EdisonAltamirano/LDO_board/Report/pcb_design_report.pdf

# EE 372B — Custom PCB Design Report

Edison Altamirano | Francisco Hernandez-Gardea | Sahan Samarakoon
| October 5, 2026

## 1 Schematic and Layout

### 1.1 Schematic

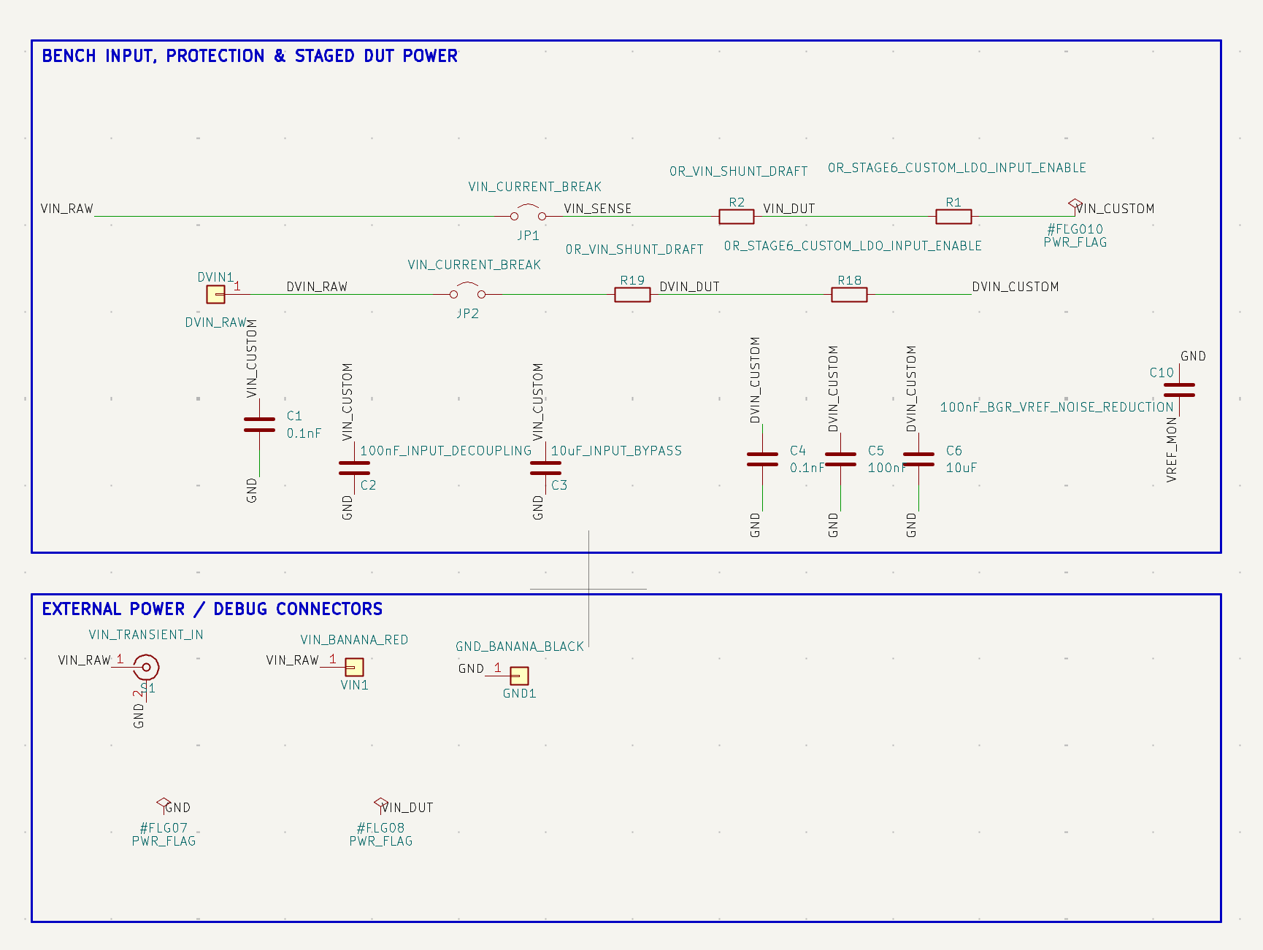
[picture p1: figure]

Figure 1: Schematic of Power Rails

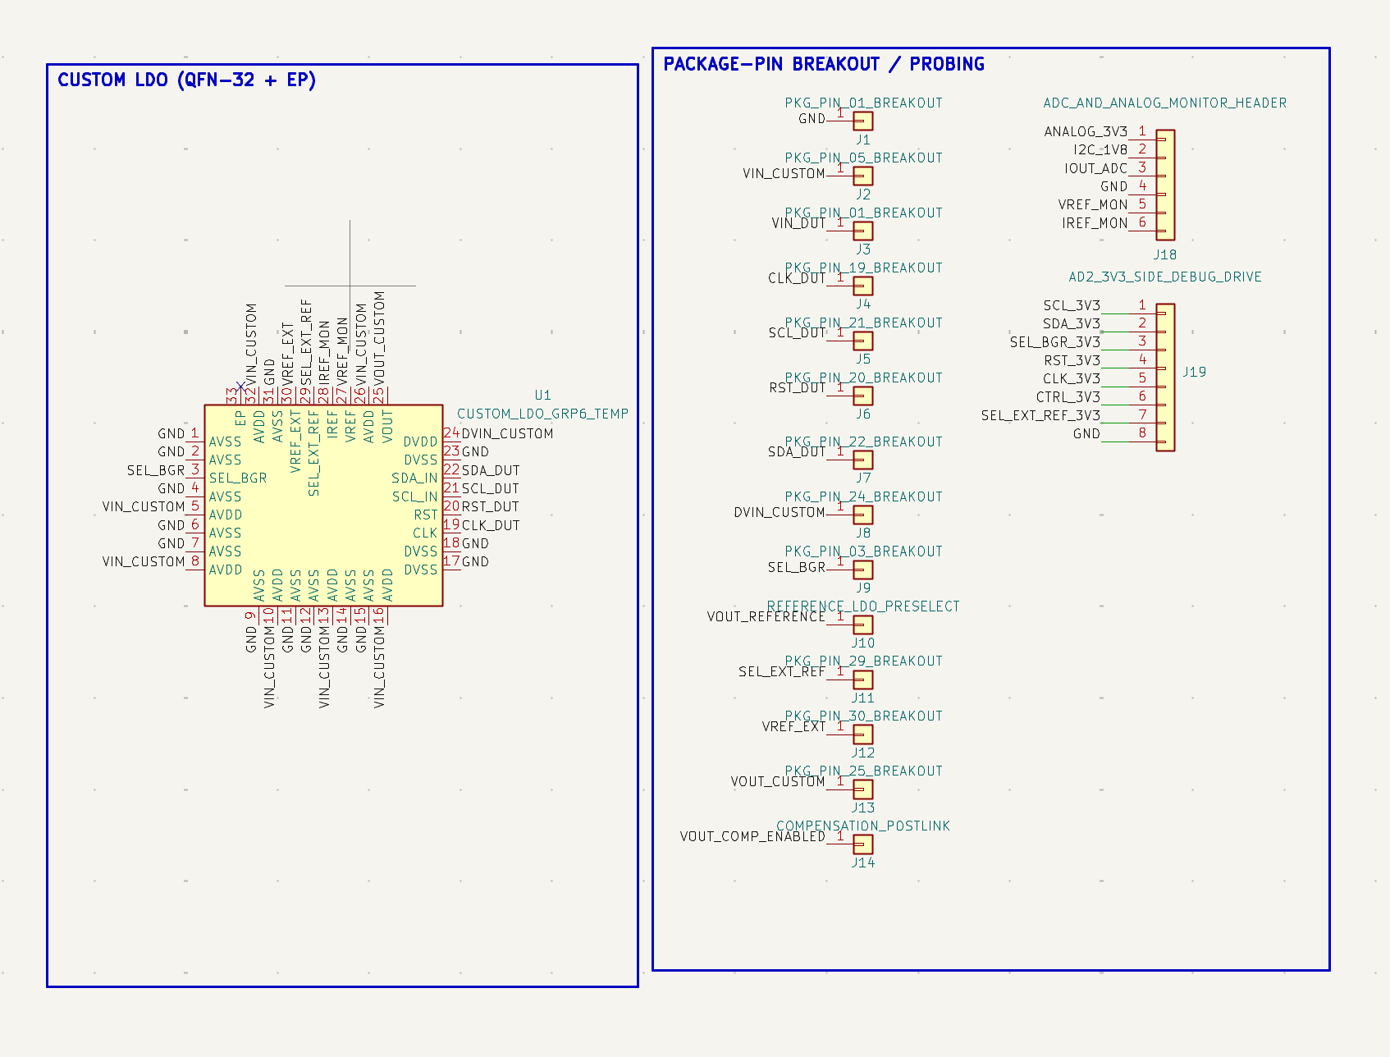
[picture p2: figure]

Figure 2: Schematic of IC and Test pins

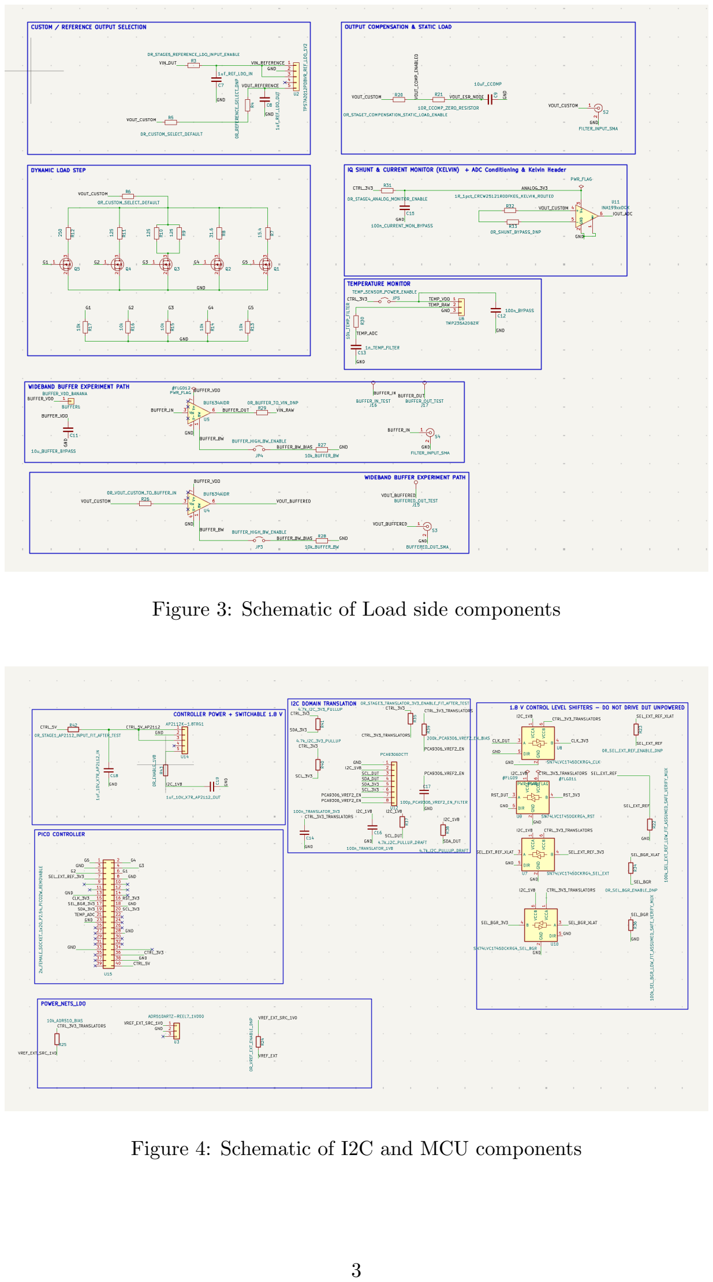
[picture p3: page 3]

Figure 3: Schematic of Load side components

Figure 4: Schematic of I2C and MCU components

### 1.2 Layout

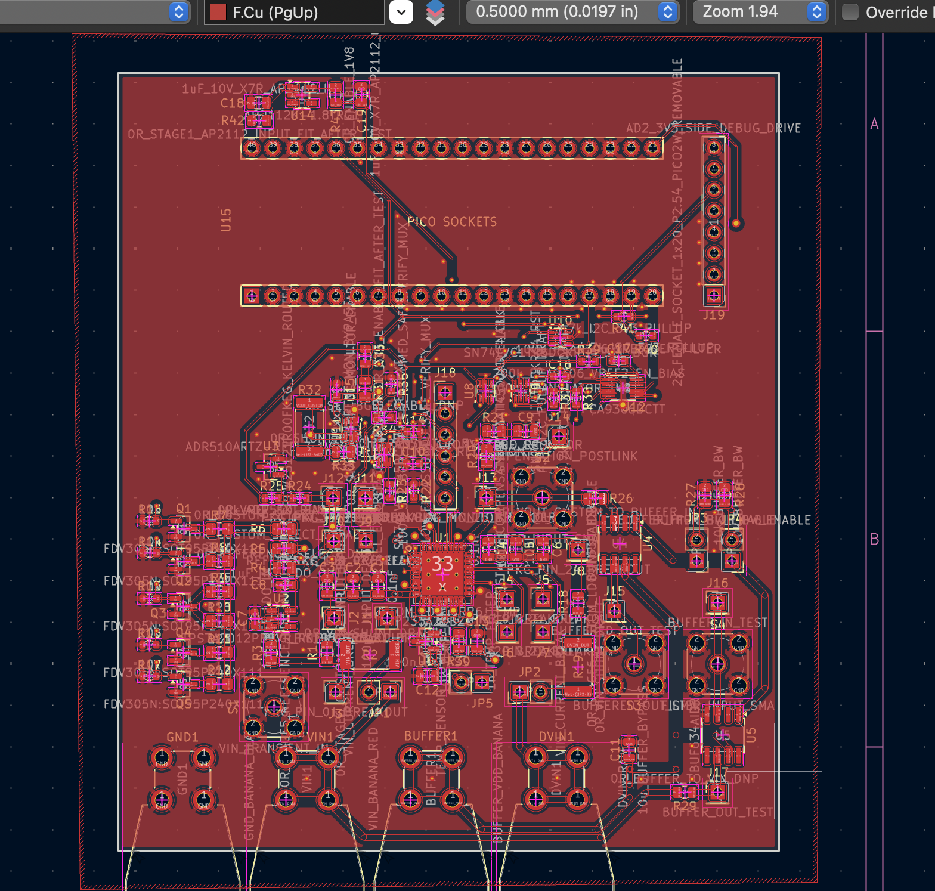
[picture p4: figure]

Figure 5: Top Layer Layout

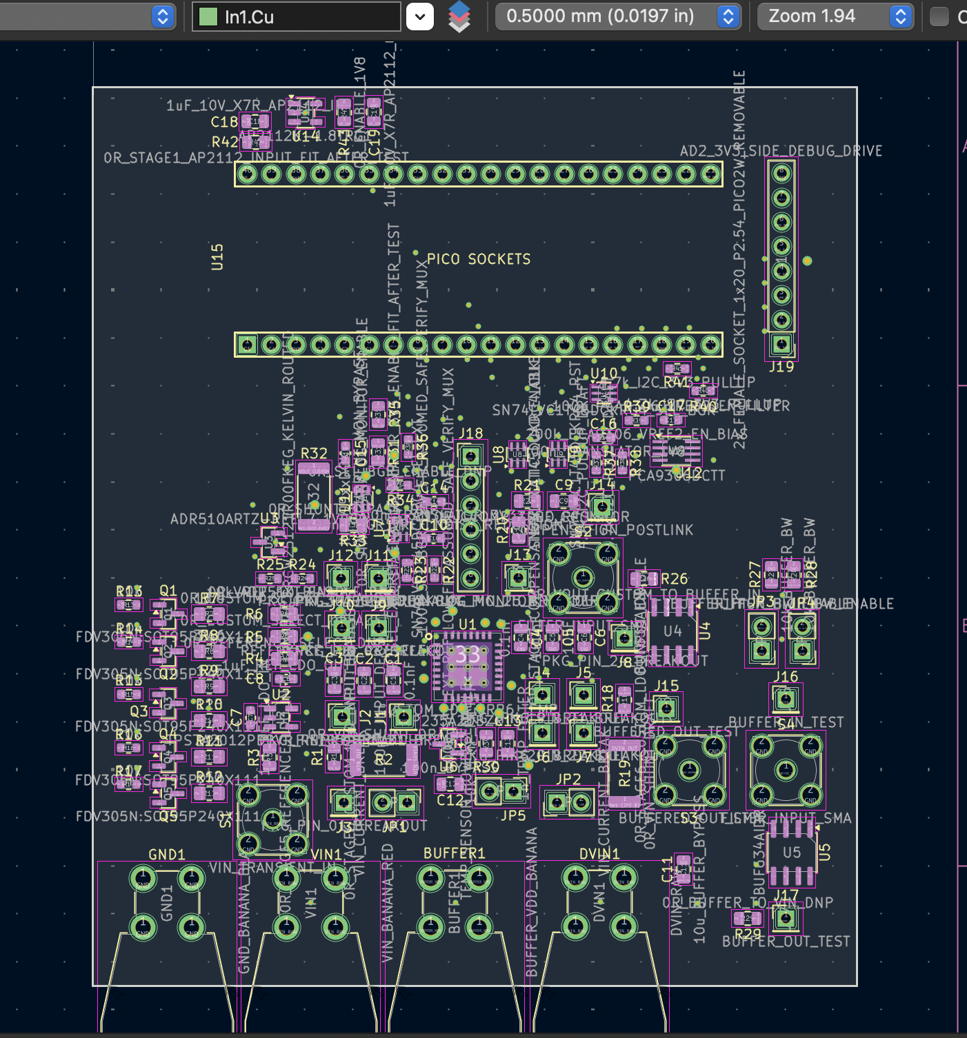
[picture p5: figure]

Figure 6: Second Layer Layout

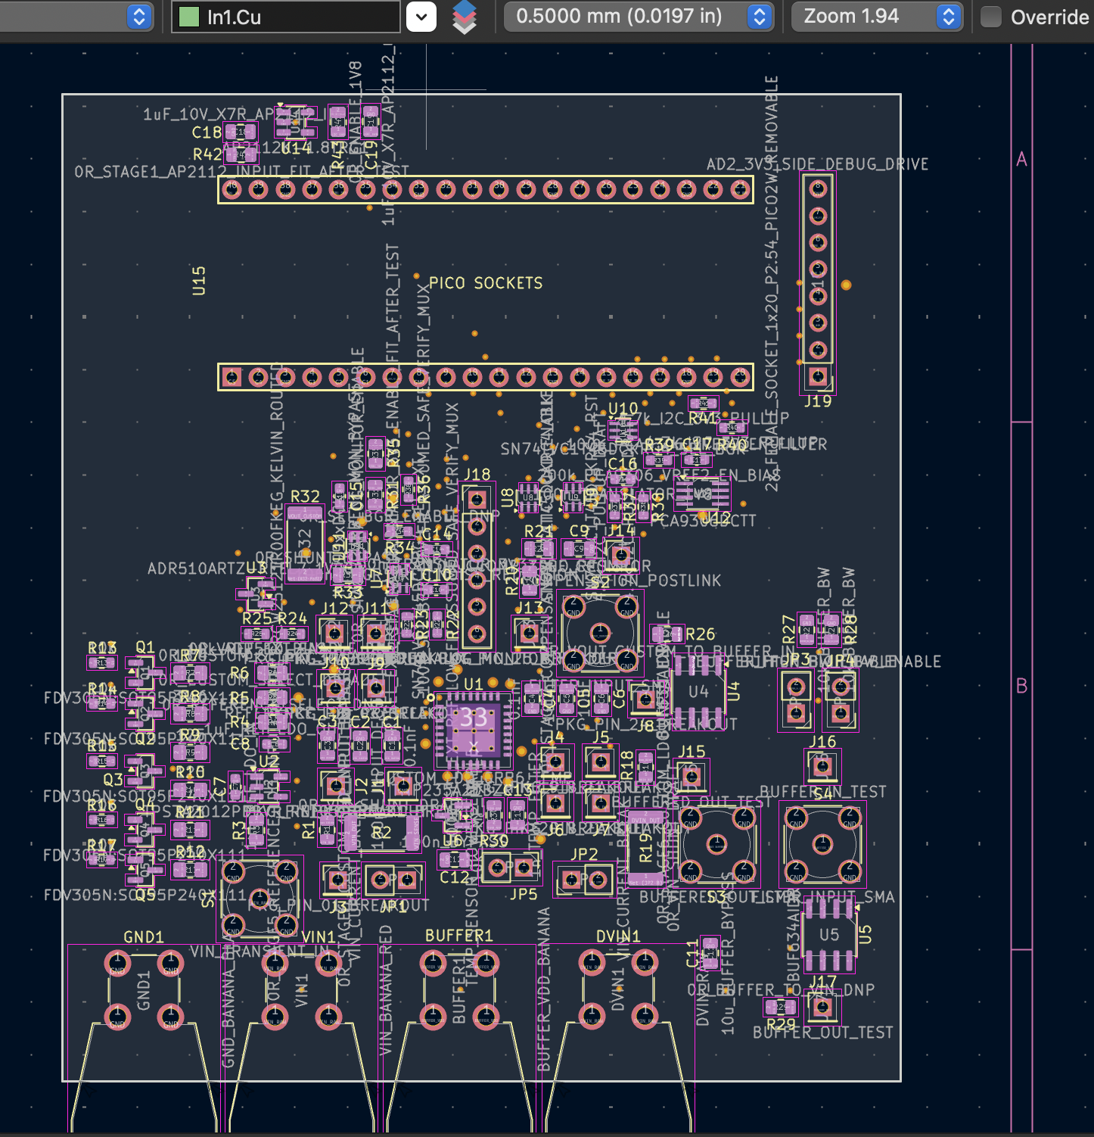
[picture p6: figure]

Figure 7: Third Layer Layout

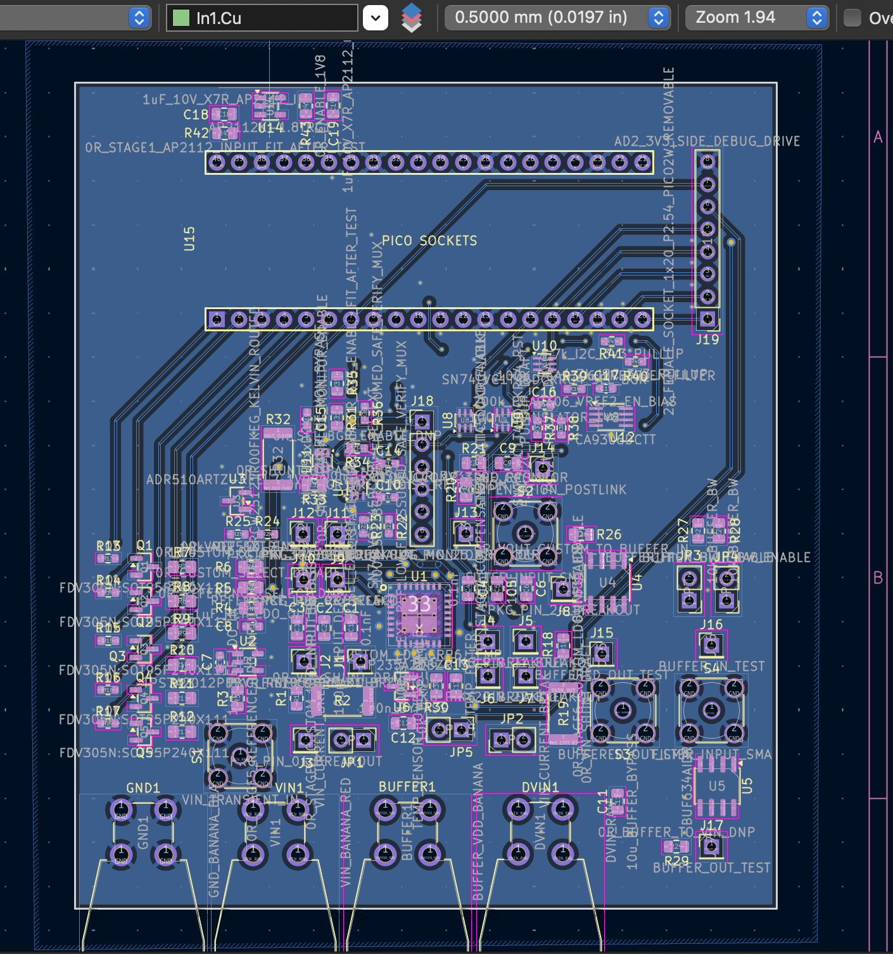
[picture p7: figure]

Figure 8: Bottom Layer Layout

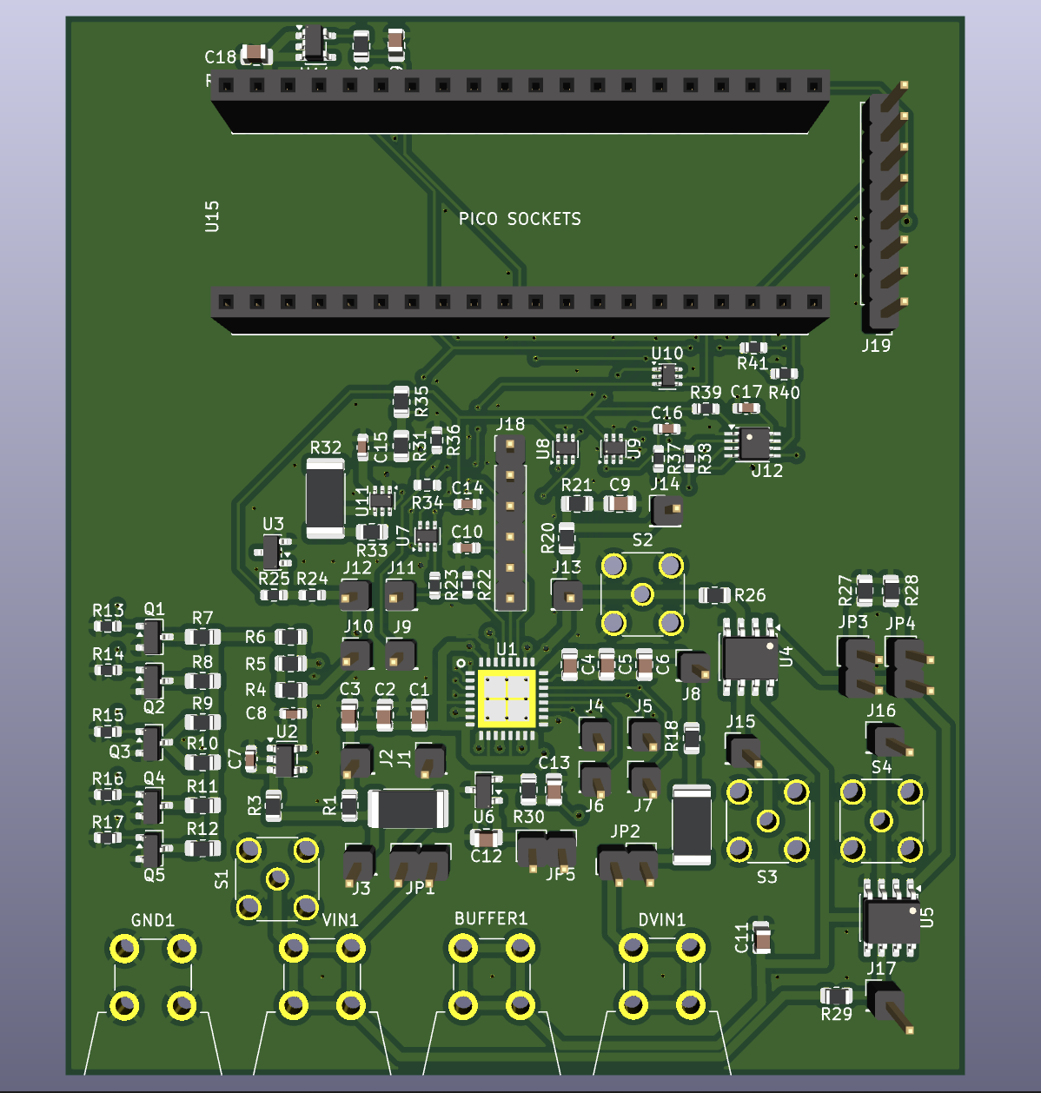
[picture p8: figure]

Figure 9: 3D View of PCB

## 2 Pin-Map and Footprint Verification

Table 1: QFN-32 + EP Footprint Dimensions

Feature | Value
Signal pad size | 0.35 mm × 0.8 mm
Pad pitch | 0.65 mm
Exposed-pad (EP) land | 5.1 mm ×5.1 mm
EP thermal vias | 9 vias, 0.3 mm drill
Courtyard | 7.55 mm × 7.55 mm

Table 2: Package Pin-Map Verification

Pkg Lead | Pad # | Pad Type | Cadence Net | KiCad Pin Name | Board Net | Checked
1 | 1 | PVSS2AC | VSS | AVSS | GND | SS
2 | 2 | PVSS2AC | VSS | AVSS | GND | SS
3 | 3 | PDB3AC | SEL BGR | SEL BGR | SEL BGR | SS
4 | 4 | PVSS2AC | VSS | AVSS | GND | SS
5 | 5 | PVDD3AC | VDD | AVDD | VIN CUSTOM | SS
6 | 6 | PVSS2AC | VSS | AVSS | GND | SS
7 | 7 | PVSS2AC | VSS | AVSS | GND | SS
8 | 8 | PVDD3AC | VDD | AVDD | VIN CUSTOM | SS
9 | 9 | PVSS2AC | VSS | AVSS | GND | SS
10 | 10 | PVDD3AC | VDD | AVDD | VIN CUSTOM | SS
11 | 11 | PVSS2AC | VSS | AVSS | GND | SS
12 | 12 | PVSS2AC | VSS | AVSS | GND | SS
13 | 13 | PVDD3AC | VDD | AVDD | VIN CUSTOM | SS
14 | 14 | PVSS2AC | VSS | AVSS | GND | SS
15 | 15 | PVSS2AC | VSS | AVSS | GND | SS
16 | 16 | PVDD3AC | VDD | AVDD | VIN CUSTOM | SS
17 | 17 | PVSS2AC | VSS | DVSS | GND | SS
18 | 18 | PVSS2AC | VSS | DVSS | GND | SS
19 | 19 | PDB3AC | CLK | CLK | CLK DUT | SS
20 | 20 | PDB3AC | RST | RST | RST DUT | SS
21 | 21 | PDB3AC | SCL IN | SCL IN | SCL DUT | SS
22 | 22 | PDB3AC | SDA IN | SDA IN | SDA DUT | SS
23 | 23 | PVSS2AC | VSS | DVSS | GND | SS
24 | 24 | PVDD3AC | VDD | DVDD | DVIN CUSTOM | SS
25 | 25 | PDB3AC | VOUT | VOUT | VOUT CUSTOM | SS
26 | 26 | PVDD3AC | VDD | AVDD | VIN CUSTOM | SS
27 | 27 | PDB3AC | VREF | VREF | VREF MON | SS
28 | 28 | PDB3AC | IREF | IREF | IREF MON | SS
29 | 29 | PDB3AC | SEL EXT REF | SEL EXT REF | SEL EXT REF | SS
30 | 30 | PDB3AC | V REF EXT | V REF EXT | V REF EXT | SS
31 | 31 | PVSS2AC | VSS | AVSS | GND | SS
32 | 32 | PVDD3AC | VDD | AVDD | VIN CUSTOM | SS
EP | 33 | EP | N/A | EP | N/A | SS

## 3 Test Features

### 3.1 Rail Inventory

Table 3 summarizes the supply and ground domains brought out from the custom IC. The analog and digital supply domains are kept separate on the PCB to allow independent characterization.

Table 3: Custom IC Rail Inventory
Board Rail | IC Domain / Pins | Nominal | Access / Isolation | Local Decoupling
VIN CUSTOM | Analog supply (AVDD), pins 5, 8, 10, 13, 16, 26,
| 32 | 1.8 V | Independent analog sup- ply path with current- break jumper and 0 Ω
series link. | Rail may
| | | be swept below 1.8 V for line-regulation and dropout measurements. | 100 pF, 100 nF, and 10 µF
DVIN CUSTOM | Digital supply (DVDD),
pin 24

1.8 V Independent digital supply path with current-break jumper and 0 Ω series link; may remain at
1.8 V while VIN CUSTOM
is swept.

100 pF, 100 nF, and 10
µF
GND | Analog | and | digital
grounds (AVSS: 1, 2, 4,
6, 7, 9, 11, 12, 14, 15,
31; DVSS: 17, 18, 23)

0 V Common solid ground
plane and ground test
points

—

The exposed pad, pin 33, is maintained as the separate EP NET connection and is not treated as an independent supply rail.

### 3.2 Specification Measurement Access

Table 4 summarizes the PCB features used to characterize the custom LDO and on-chip reference circuits.

Table 4: Specification-to-Board Measurement Feature Mapping
Specification | Relevant Net(s) | Board Measurement Feature
DC output voltage | VOUT CUSTOM | Direct custom-LDO output test point
| | (TP37); additional monitored output
| | available through the VOUT measure-
| | ment path.
Line regulation / dropout | VIN CUSTOM, VOUT CUSTOM | Sweep the analog bench supply while
| | monitoring VIN CUSTOM at TP28 and
| | the custom LDO output. DVIN CUSTOM
| | can remain independently powered at
| | 1.8 V.
Load regulation | VOUT, VOUT EXTERNAL | J110 external-load terminal block; 1
| | Ω Kelvin current shunt and INA180
| | current monitor provide load-current
| | measurement.
Load transient response | DYN GATE DRIVE, VOUT | J102 LOAD STEP DRIVE SMA drives
| | the MOSFET load-step circuit; mon-
| | itor VOUT using TP45 or J114.
PSRR | VIN RAW/VIN CUSTOM, VOUT | J59 VIN TRANSIENT IN SMA provides
| | AC input injection; output ripple is
| | observed at J114 VOUT SCOPE NOISE.
Output noise | VOUT | J114 VOUT SCOPE NOISE SMA provides
| | a coaxial connection for low-noise out-
| | put measurement.
Quiescent current (IQ) | VIN CUSTOM | Remove the analog VIN current-break
| | jumper and insert a DMM or SMU in
| | series with the DUT analog supply.
Reference voltage | VREF MON | VREF probe access through J68
| | and the analog monitor header J111;
| | package-pin breakout also provides di-
| | rect access.
Reference current | IREF MON | IREF probe access through J68 and
| | the analog monitor header J111;
| | package-pin breakout also provides di-
| | rect access.
Temperature dependence | VOUT, VREF MON, TEMP ADC | On-board temperature monitor can be
| | read by the Pico and correlated with
| | VOUT and VREF measurements.
Digital control / trim | SDA DUT, SCL DUT, CLK DUT, RST DUT | Pico controller and 1.8 V level-
| | translation circuitry exercise the dig-
| | ital interface; all DUT pins are addi-
| | tionally broken out for probing.

## 4 DRC and ERC Reports

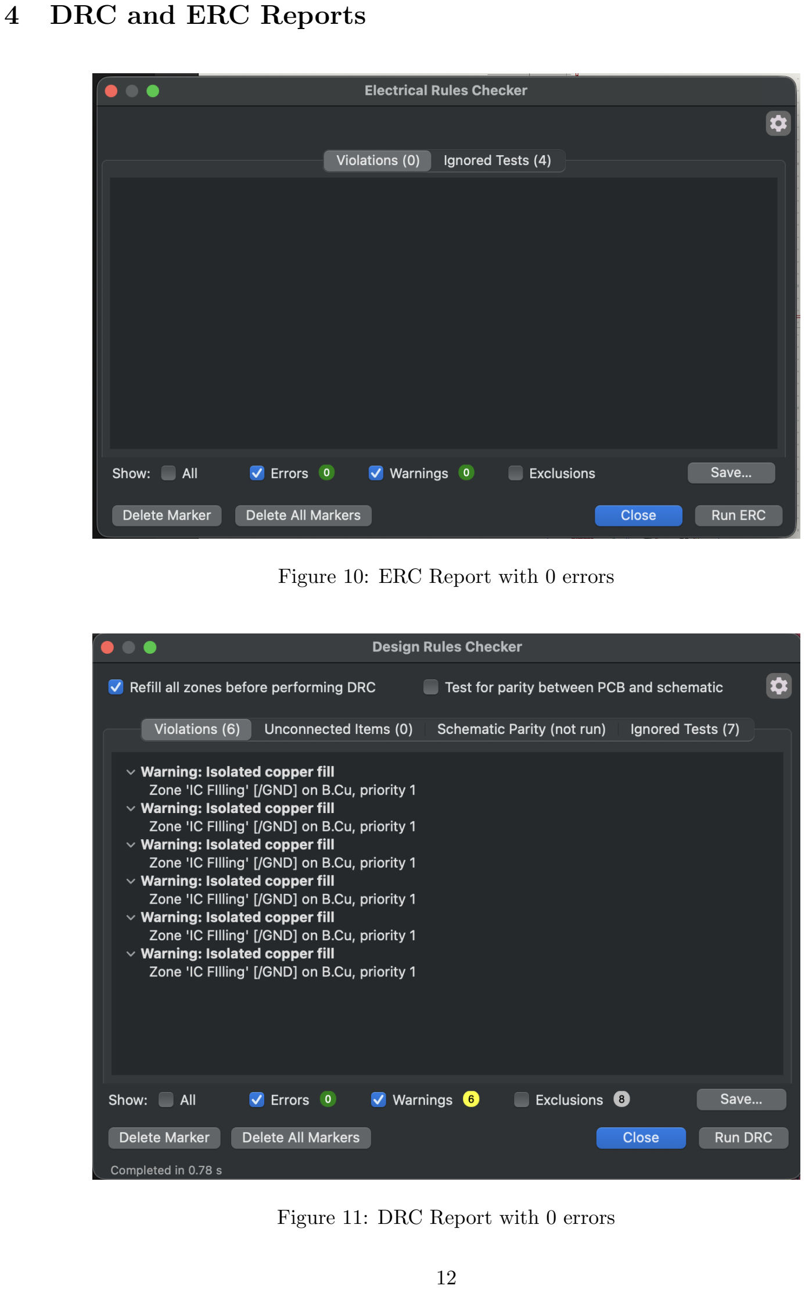
[picture p9: page 12]

Figure 10: ERC Report with 0 errors

Figure 11: DRC Report with 0 errors
