EdisonAltamirano/LDO_board/GerberFiles/board_bottom.png

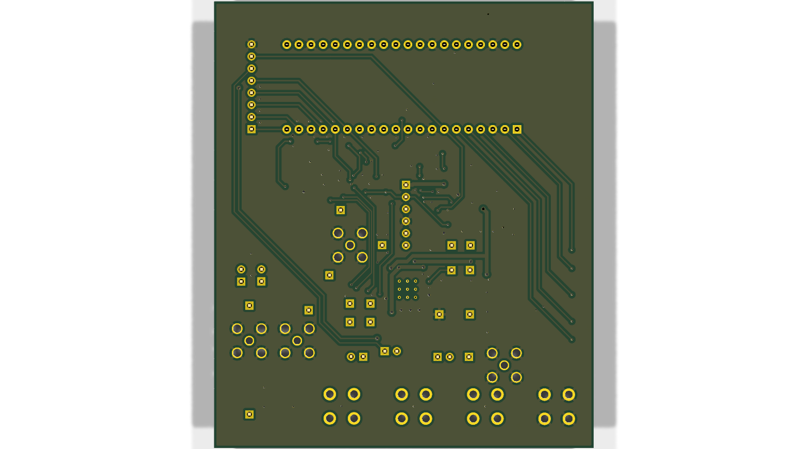
GerberFiles/board_bottom.png
