EdisonAltamirano/LDO_board/GerberFiles/board_top.png

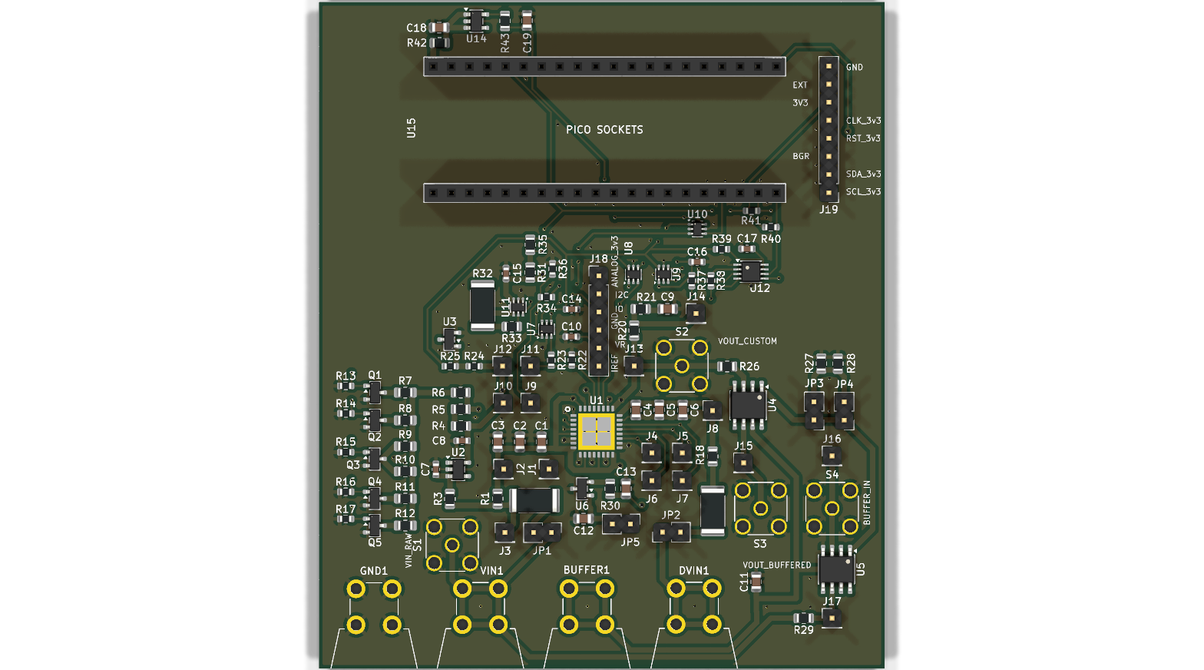
GerberFiles/board_top.png
