EdisonAltamirano/LDO_board/BOM/BOM_ldo.csv

Index | Quantity | Part Number | Manufacturer Part Number | Description | Unit of Measure | Customer Reference | Available | Backorder | Unit Price | Extended Price USD
1 | 2 | 399-15004-1-ND | C0805C101K8RACTU | CAP CER 100PF 10V X7R 0805 |  |  | 2 | 0 | 0.36000 | $0.72
2 | 3 | 399-C0805C104K8RACTUCT-ND | C0805C104K8RACTU | CAP CER 0.1UF 10V X7R 0805 |  |  | 3 | 0 | 0.22000 | $0.66
3 | 3 | 399-15687-1-ND | C0805C106K8RACAUTO | CAP CER 10UF 10V X7R 0805 |  |  | 3 | 0 | 0.70000 | $2.10
4 | 2 | 399-C0805C105K8RACTUCT-ND | C0805C105K8RACTU | CAP CER 1UF 10V X7R 0805 |  |  | 2 | 0 | 0.33000 | $0.66
5 | 4 | 399-C0603C104K5RACTUCT-ND | C0603C104K5RACTU | CAP CER 0.1UF 50V X7R 0603 |  |  | 4 | 0 | 0.14000 | $0.56
6 | 1 | 399-C0603C101J5GACTUCT-ND | C0603C101J5GACTU | CAP CER 100PF 50V C0G/NP0 0603 |  |  | 1 | 0 | 0.14000 | $0.14
7 | 2 | 399-C0603C105K4RACTUCT-ND | C0603C105K4RACTU | CAP CER 1UF 16V X7R 0603 |  |  | 2 | 0 | 0.15000 | $0.30
8 | 1 | 399-C0805C102K5GECAUTOCT-ND | C0805C102K5GECAUTO | CAP CER 0805 1NF 50V C0G 10% |  |  | 1 | 0 | 0.26000 | $0.26
9 | 1 | 445-8806-1-ND | CGA5L1X7R1E106K160AE | CAP CER 10UF 25V X7R 1206 |  |  | 1 | 0 | 1.20000 | $1.20
10 | 2 | 277-1258-ND | 1715022 | TERM BLK 2POS SIDE ENTRY 5MM PCB |  |  | 2 | 0 | 1.16000 | $2.32
11 | 4 | ACX1230-ND | 132134 | CONN SMA JACK STR 50 OHM PCB |  |  | 4 | 0 | 7.30000 | $29.20
12 | 2 | BKCT3151SP-2-ND | CT3151SP-2 | CONN BANANA JACK SOLDER RED |  |  | 2 | 0 | 2.55000 | $5.10
13 | 1 | BKCT3151SP-6-ND | CT3151SP-6 | CONN BANANA JACK SOLDER BLUE |  |  | 1 | 0 | 2.55000 | $2.55
14 | 1 | BKCT3151SP-0-ND | CT3151SP-0 | CONN BANANA JACK SOLDER BLACK |  |  | 1 | 0 | 2.55000 | $2.55
15 | 5 | 35-PBC02SAAN-ND | PBC02SAAN | CONN HEADER VERT 2POS 2.54MM |  |  | 5 | 0 | 0.25000 | $1.25
16 | 2 | S7018-ND | PPTC201LFBN-RC | CONN HDR 20POS 0.1 TIN PCB |  |  | 2 | 0 | 1.15000 | $2.30
17 | 1 | 35-PBC08SAAN-ND | PBC08SAAN | CONN HEADER VERT 8POS 2.54MM |  |  | 1 | 0 | 0.75000 | $0.75
18 | 12 | 35-PBC01SAAN-ND | PBC01SAAN | CONN HEADER VERT 1POS |  |  | 12 | 0 | 0.11100 | $1.33
19 | 1 | 35-PBC06SAAN-ND | PBC06SAAN | CONN HEADER VERT 6POS 2.54MM |  |  | 1 | 0 | 0.60000 | $0.60
20 | 5 | FDV305NCT-ND | FDV305N | MOSFET N-CH 20V 900MA SOT23 |  |  | 5 | 0 | 0.52000 | $2.60
21 | 2 | YAG1232CT-ND | RC2512JK-070RL | RES 0 OHM JUMPER 1W 2512 |  |  | 2 | 0 | 0.21000 | $0.42
22 | 30 | RMCF0805ZT0R00CT-ND | RMCF0805ZT0R00 | RES 0 OHM JUMPER 1/8W 0805 |  |  | 30 | 0 | 0.00880 | $0.26
23 | 1 | RMCF0603FT200KCT-ND | RMCF0603FT200K | RES 200K OHM 1% 1/10W 0603 |  |  | 1 | 0 | 0.10000 | $0.10
24 | 2 | 311-100KHRCT-ND | RC0603FR-07100KL | RES 100K OHM 1% 1/10W 0603 |  |  | 2 | 0 | 0.10000 | $0.20
25 | 2 | 541-1.00AAFCT-ND | CRCW25121R00FKEG | RES SMD 1 OHM 1% 1W 2512 |  |  | 2 | 0 | 0.34000 | $0.68
26 | 1 | 311-10.0CRCT-ND | RC0805FR-0710RL | RES 10 OHM 1% 1/8W 0805 |  |  | 1 | 0 | 0.12000 | $0.12
27 | 1 | A140011CT-ND | RQ73C2A249RBTD | RES 249 OHMS 0.1% 1/5W 0805 |  |  | 1 | 0 | 0.60000 | $0.60
28 | 3 | A139850CT-ND | RQ73C2A124RBTD | RES 124 OHMS 0.1% 1/5W 0805 |  |  | 3 | 0 | 0.64000 | $1.92
29 | 1 | A140166CT-ND | RQ73C2A31R6BTD | RES 31.6 OHMS 0.1% 1/5W 0805 |  |  | 1 | 0 | 0.57000 | $0.57
30 | 1 | A139511CT-ND | RQ73C2A15R4BTD | RES 15.4 OHMS 0.1% 1/5W 0805 |  |  | 1 | 0 | 0.57000 | $0.57
31 | 4 | 36-5010-ND | 5010 | PC TEST POINT MULTIPURPOSE RED |  |  | 4 | 0 | 0.42000 | $1.68
32 | 1 | 296-27331-1-ND | INA199A2DCKR | IC OP AMP SC-70-6 |  |  | 1 | 0 | 0.64000 | $0.64
33 | 1 | 505-ADR510ARTZ-REEL7CT-ND | ADR510ARTZ-REEL7 | IC VREF SHUNT 0.35% SOT23-3 |  |  | 1 | 0 | 2.73000 | $2.73
34 | 1 | AP2112K-1.8TRG1DICT-ND | AP2112K-1.8TRG1 | IC REG LINEAR 1.8V 600MA SOT-25 |  |  | 1 | 0 | 0.26000 | $0.26
35 | 1 | 296-32200-1-ND | PCA9306DCTT | IC XLTR VL BIDIR SM8 |  |  | 1 | 0 | 1.41000 | $1.41
36 | 4 | 296-35969-1-ND | SN74LVC1T45DCKRG4 | IC XLTR VL BIDIR SC-70-6 |  |  | 4 | 0 | 0.92000 | $3.68
37 | 1 | 296-TMP235A2DBZRCT-ND | TMP235A2DBZR | LOW-POWER HIGH-ACCURACY ANALOG O |  |  | 1 | 0 | 0.56000 | $0.56
38 | 2 | 296-53619-1-ND | BUF634AIDR | IC OP AMP 1CH 8-SOIC |  |  | 2 | 0 | 4.63000 | $9.26
39 | 1 | 296-TPS7A2012PDBVRCT-ND | TPS7A2012PDBVR | IC REG LINEAR 1.2V 300MA SOT23-5 |  |  | 1 | 0 | 0.37000 | $0.37
40 | 6 | 311-10.0KHRCT-ND | RC0603FR-0710KL | RES 10K OHM 1% 1/10W 0603 |  |  | 6 | 0 | 0.10000 | $0.60
41 | 3 | RMCF0805FT10K0CT-ND | RMCF0805FT10K0 | RES 10K OHM 1% 1/8W 0805 |  |  | 3 | 0 | 0.10000 | $0.30
42 | 5 | S9001-ND | SPC02SYAN | CONN JUMPER SHORTING GOLD FLASH |  |  | 5 | 0 | 0.10000 | $0.50
43 | 4 | 311-4.70KHRCT-ND | RC0603FR-074K7L | RES 4.7K OHM 1% 1/10W 0603 |  |  | 4 | 0 | 0.10000 | $0.40
44 | 4 | 13-PA2512FKE7W0R1ECT-ND | PA2512FKE7W0R1E | RES 0.1 OHM 1% 2W 2512 |  |  | 4 | 0 | 0.52000 | $2.08
