EdisonAltamirano/LDO_board/GerberFiles/bom/BOM_schematic.csv

References | Value | Footprint | Quantity | DNP
BUFFER1 | BUFFER_VDD_BANANA | Connector:CalTest_CT3151 | 1
C1,C4 | 0.1nF | Capacitor_SMD:C_0805_2012Metric | 2
C2 | 100nF_INPUT_DECOUPLING | Capacitor_SMD:C_0805_2012Metric | 1
C3 | 10uF_INPUT_BYPASS | Capacitor_SMD:C_0805_2012Metric | 1
C5 | 100nF | Capacitor_SMD:C_0805_2012Metric | 1
C6 | 10uF | Capacitor_SMD:C_0805_2012Metric | 1
C7 | 1uF_REF_LDO_IN | Capacitor_SMD:C_0603_1608Metric | 1
C8 | 1uF_REF_LDO_OUT | Capacitor_SMD:C_0603_1608Metric | 1
C9 | 10uF_CCOMP | Capacitor_SMD:C_0805_2012Metric | 1
C10 | 100nF_BGR_VREF_NOISE_REDUCTION | Capacitor_SMD:C_0603_1608Metric | 1
C11 | 10u_BUFFER_BYPASS | Capacitor_SMD:C_0805_2012Metric | 1
C12 | 100n_BYPASS | Capacitor_SMD:C_0805_2012Metric | 1
C13 | 1n_TEMP_FILTER | Capacitor_SMD:C_0805_2012Metric | 1
C14 | 100n_TRANSLATOR_3V3 | Capacitor_SMD:C_0603_1608Metric | 1
C15 | 100n_CURRENT_MON_BYPASS | Capacitor_SMD:C_0603_1608Metric | 1
C16 | 100n_TRANSLATOR_1V8 | Capacitor_SMD:C_0603_1608Metric | 1
C17 | 100p_PCA9306_VREF2_EN_FILTER | Capacitor_SMD:C_0603_1608Metric | 1
C18 | 1uF_10V_X7R_AP2112_IN | Capacitor_SMD:C_0805_2012Metric | 1
C19 | 1uF_10V_X7R_AP2112_OUT | Capacitor_SMD:C_0805_2012Metric | 1
DVIN1 | DVIN_RAW | Connector:CalTest_CT3151 | 1
GND1 | GND_BANANA_BLACK | Connector:CalTest_CT3151 | 1
J1,J3 | PKG_PIN_01_BREAKOUT | Connector_PinHeader_2.54mm:PinHeader_1x01_P2.54mm_Vertical | 2
J2 | PKG_PIN_05_BREAKOUT | Connector_PinHeader_2.54mm:PinHeader_1x01_P2.54mm_Vertical | 1
J4 | PKG_PIN_19_BREAKOUT | Connector_PinHeader_2.54mm:PinHeader_1x01_P2.54mm_Vertical | 1
J5 | PKG_PIN_21_BREAKOUT | Connector_PinHeader_2.54mm:PinHeader_1x01_P2.54mm_Vertical | 1
J6 | PKG_PIN_20_BREAKOUT | Connector_PinHeader_2.54mm:PinHeader_1x01_P2.54mm_Vertical | 1
J7 | PKG_PIN_22_BREAKOUT | Connector_PinHeader_2.54mm:PinHeader_1x01_P2.54mm_Vertical | 1
J8 | PKG_PIN_24_BREAKOUT | Connector_PinHeader_2.54mm:PinHeader_1x01_P2.54mm_Vertical | 1
J9 | PKG_PIN_03_BREAKOUT | Connector_PinHeader_2.54mm:PinHeader_1x01_P2.54mm_Vertical | 1
J10 | REFERENCE_LDO_PRESELECT | Connector_PinHeader_2.54mm:PinHeader_1x01_P2.54mm_Vertical | 1
J11 | PKG_PIN_29_BREAKOUT | Connector_PinHeader_2.54mm:PinHeader_1x01_P2.54mm_Vertical | 1
J12 | PKG_PIN_30_BREAKOUT | Connector_PinHeader_2.54mm:PinHeader_1x01_P2.54mm_Vertical | 1
J13 | PKG_PIN_25_BREAKOUT | Connector_PinHeader_2.54mm:PinHeader_1x01_P2.54mm_Vertical | 1
J14 | COMPENSATION_POSTLINK | Connector_PinHeader_2.54mm:PinHeader_1x01_P2.54mm_Vertical | 1
J15 | BUFFERED_OUT_TEST | Connector_PinHeader_2.54mm:PinHeader_1x01_P2.54mm_Vertical | 1
J16 | BUFFER_IN_TEST | Connector_PinHeader_2.54mm:PinHeader_1x01_P2.54mm_Vertical | 1
J17 | BUFFER_OUT_TEST | Connector_PinHeader_2.54mm:PinHeader_1x01_P2.54mm_Vertical | 1
J18 | ADC_AND_ANALOG_MONITOR_HEADER | Connector_PinHeader_2.54mm:PinHeader_1x06_P2.54mm_Vertical | 1
J19 | AD2_3V3_SIDE_DEBUG_DRIVE | Connector_PinHeader_2.54mm:PinHeader_1x08_P2.54mm_Vertical | 1
JP1,JP2 | VIN_CURRENT_BREAK | Connector_PinHeader_2.54mm:PinHeader_1x02_P2.54mm_Vertical | 2
JP3,JP4 | BUFFER_HIGH_BW_ENABLE | Connector_PinHeader_2.54mm:PinHeader_1x02_P2.54mm_Vertical | 2
JP5 | TEMP_SENSOR_POWER_ENABLE | Connector_PinHeader_2.54mm:PinHeader_1x02_P2.54mm_Vertical | 1
Q1-Q5 | FDV305N:SOT95P240X111 | Package_TO_SOT_SMD:SOT-23 | 5
R1,R18 | 0R_STAGE6_CUSTOM_LDO_INPUT_ENABLE | Resistor_SMD:R_0805_2012Metric | 2
R2,R19 | 0R_VIN_SHUNT_DRAFT | Resistor_SMD:R_2512_6332Metric | 2
R3 | 0R_STAGE5_REFERENCE_LDO_INPUT_ENABLE | Resistor_SMD:R_0805_2012Metric | 1
R4 | 0R_REFERENCE_SELECT_DNP | Resistor_SMD:R_0805_2012Metric | 1
R5,R6 | 0R_CUSTOM_SELECT_DEFAULT | Resistor_SMD:R_0805_2012Metric | 2
R7 | 15.4 | Resistor_SMD:R_0805_2012Metric_Pad1.20x1.40mm_HandSolder | 1
R8 | 31.6 | Resistor_SMD:R_0805_2012Metric_Pad1.20x1.40mm_HandSolder | 1
R9-R11 | 125 | Resistor_SMD:R_0805_2012Metric_Pad1.20x1.40mm_HandSolder | 3
R12 | 250 | Resistor_SMD:R_0805_2012Metric_Pad1.20x1.40mm_HandSolder | 1
R13-R17 | 10k | Resistor_SMD:R_0603_1608Metric | 5
R20 | 0R_STAGE7_COMPENSATION_STATIC_LOAD_ENABLE | Resistor_SMD:R_0805_2012Metric | 1
R21 | 10R_CCOMP_ZERO_RESISTOR | Resistor_SMD:R_0805_2012Metric | 1
R22 | 100k_SEL_EXT_REF_LOW_FIT_ASSUMED_SAFE_VERIFY_MUX | Resistor_SMD:R_0603_1608Metric | 1
R23 | 0R_SEL_EXT_REF_ENABLE_DNP | Resistor_SMD:R_0603_1608Metric | 1
R24 | 0R_VREF_EXT_ENABLE_DNP | Resistor_SMD:R_0603_1608Metric | 1
R25 | 10k_ADR510_BIAS | Resistor_SMD:R_0603_1608Metric | 1
R26 | 0R_VOUT_CUSTOM_TO_BUFFER_IN | Resistor_SMD:R_0805_2012Metric | 1
R27,R28 | 10k_BUFFER_BW | Resistor_SMD:R_0805_2012Metric | 2
R29 | 0R_BUFFER_TO_VIN_DNP | Resistor_SMD:R_0805_2012Metric | 1
R30 | 10k_TEMP_FILTER | Resistor_SMD:R_0805_2012Metric | 1
R31 | 0R_STAGE4_ANALOG_MONITOR_ENABLE | Resistor_SMD:R_0805_2012Metric | 1
R32 | 1R_1pct_CRCW25121R00FKEG_KELVIN_ROUTED | Resistor_SMD:R_2512_6332Metric | 1
R33 | 0R_SHUNT_BYPASS_DNP | Resistor_SMD:R_0805_2012Metric | 1
R34 | 0R_SEL_BGR_ENABLE_DNP | Resistor_SMD:R_0603_1608Metric | 1
R35 | 0R_STAGE3_TRANSLATOR_3V3_ENABLE_FIT_AFTER_TEST | Resistor_SMD:R_0805_2012Metric | 1
R36 | 100k_SEL_BGR_LOW_FIT_ASSUMED_SAFE_VERIFY_MUX | Resistor_SMD:R_0603_1608Metric | 1
R37,R38 | 4.7k_I2C_PULLUP_DRAFT | Resistor_SMD:R_0603_1608Metric | 2
R39 | 200k_PCA9306_VREF2_EN_BIAS | Resistor_SMD:R_0603_1608Metric | 1
R40,R41 | 4.7k_I2C_3V3_PULLUP | Resistor_SMD:R_0603_1608Metric | 2
R42 | 0R_STAGE1_AP2112_INPUT_FIT_AFTER_TEST | Resistor_SMD:R_0805_2012Metric | 1
R43 | 0R_ENABLE_1V8 | Resistor_SMD:R_0805_2012Metric | 1
S1 | VIN_TRANSIENT_IN | Connector_Coaxial:SMA_Amphenol_132134_Vertical | 1
S2,S4 | FILTER_INPUT_SMA | Connector_Coaxial:SMA_Amphenol_132134_Vertical | 2
S3 | BUFFERED_OUT_SMA | Connector_Coaxial:SMA_Amphenol_132134_Vertical | 1
U1 | CUSTOM_LDO_GRP6_TEMP | custom_footprints:QFN32_7x7_P0.65_TEMP | 1
U2 | TPS7A2012PDBVR_REF_LDO_1V2 | Package_TO_SOT_SMD:SOT-23-5 | 1
U3 | ADR510ARTZ-REEL7_1V000 | Package_TO_SOT_SMD:SOT-23 | 1
U4,U5 | BUF634AIDR | Package_SO:SOIC-8_3.9x4.9mm_P1.27mm | 2
U6 | TMP235A2DBZR | Package_TO_SOT_SMD:SOT-23 | 1
U7 | SN74LVC1T45DCKRG4_SEL_EXT | Package_TO_SOT_SMD:SOT-363_SC-70-6 | 1
U8 | SN74LVC1T45DCKRG4_CLK | Package_TO_SOT_SMD:SOT-363_SC-70-6 | 1
U9 | SN74LVC1T45DCKRG4_RST | Package_TO_SOT_SMD:SOT-363_SC-70-6 | 1
U10 | SN74LVC1T45DCKRG4_SEL_BGR | Package_TO_SOT_SMD:SOT-363_SC-70-6 | 1
U11 | INA199xxDCK | Package_TO_SOT_SMD:SOT-363_SC-70-6 | 1
U12 | PCA9306DCTT | Package_SO:SSOP-8_2.95x2.8mm_P0.65mm | 1
U14 | AP2112K-1.8TRG1 | Package_TO_SOT_SMD:SOT-23-5 | 1
U15 | 2x_FEMALE_SOCKET_1x20_P2.54_PICO2W_REMOVABLE | custom_footprints:Pico_2W_Dual_1x20_Female_Sockets | 1
VIN1 | VIN_BANANA_RED | Connector:CalTest_CT3151 | 1
