EdisonAltamirano/LDO_board/SchematicFiles/ldo_eval.kicad_pcb

## KiCad design SchematicFiles/ldo_eval.kicad_pcb (2026-10-05)

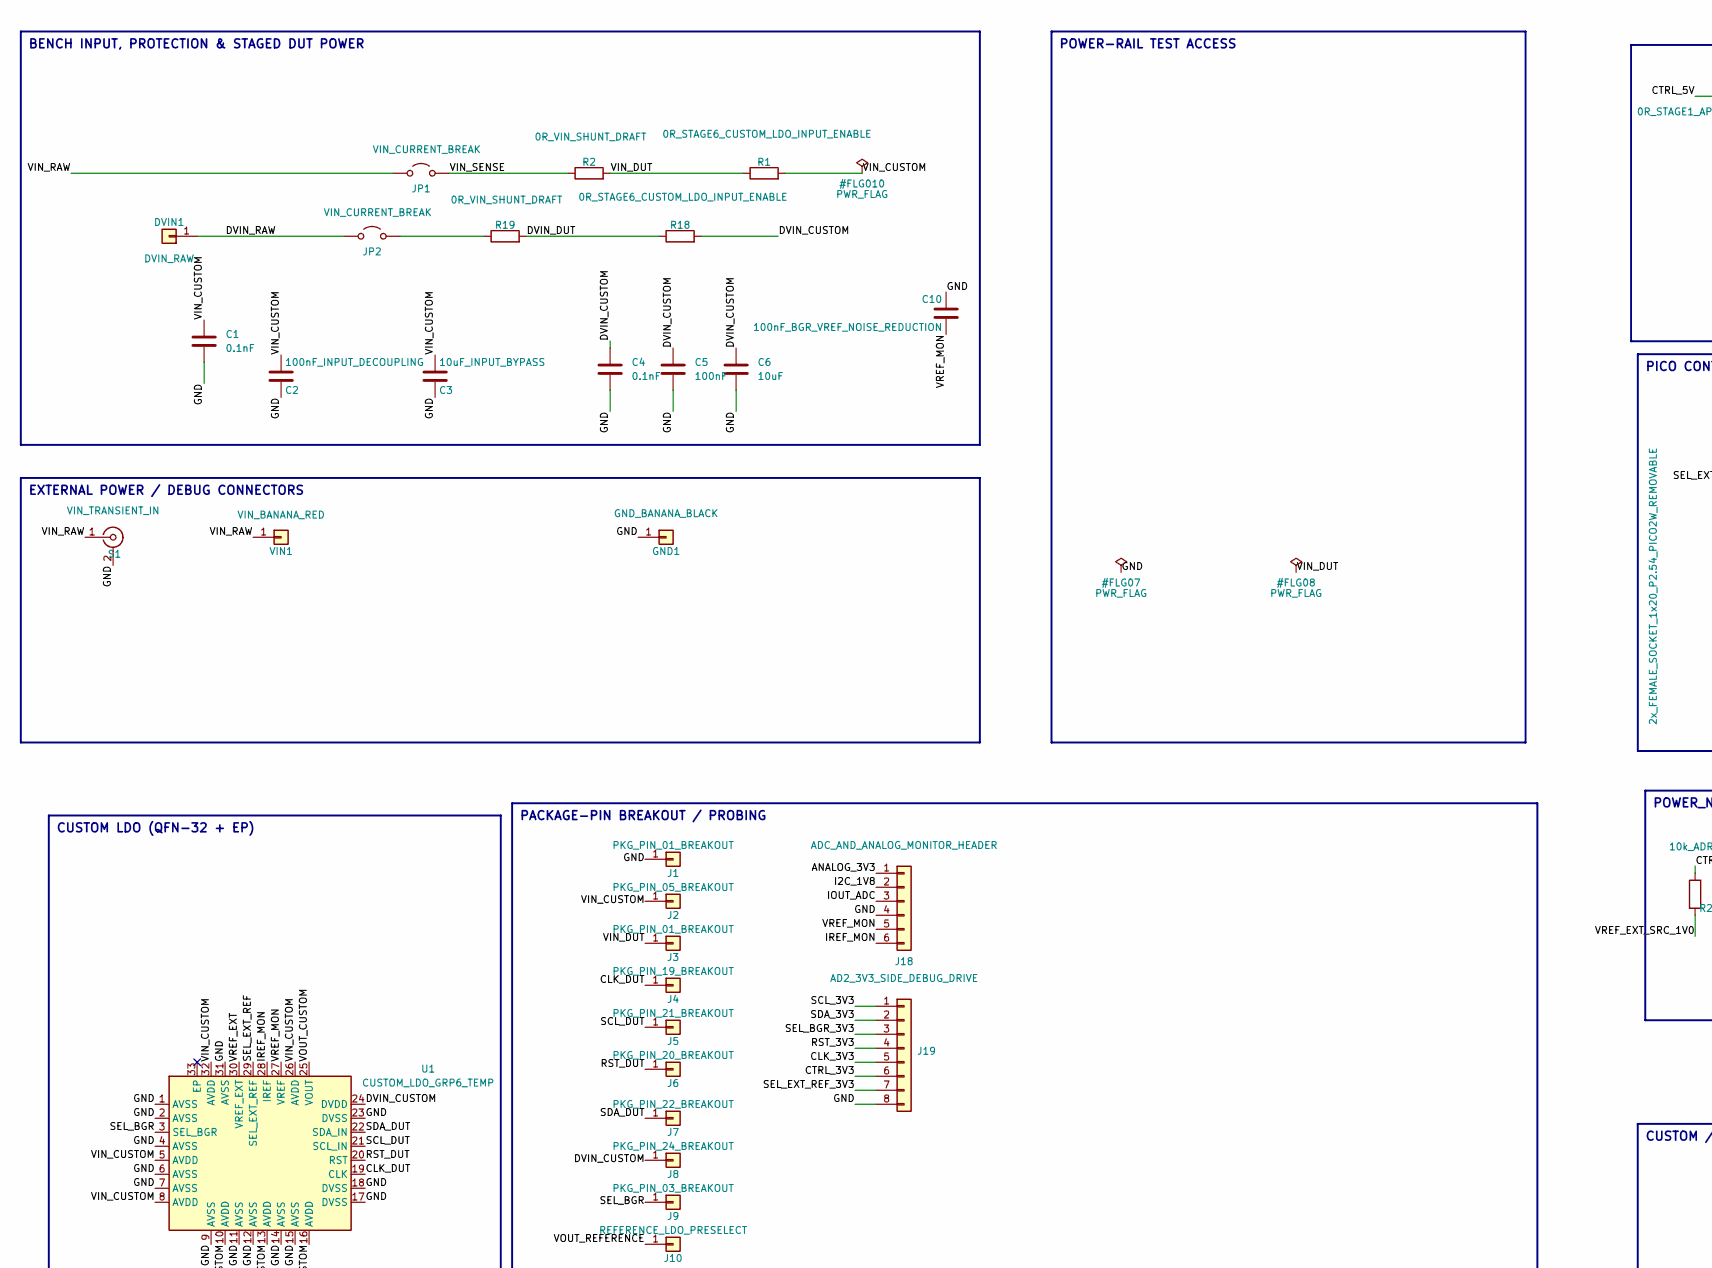
[picture p12: schematic ldo_eval.kicad_sch, part in row 1, column 1]

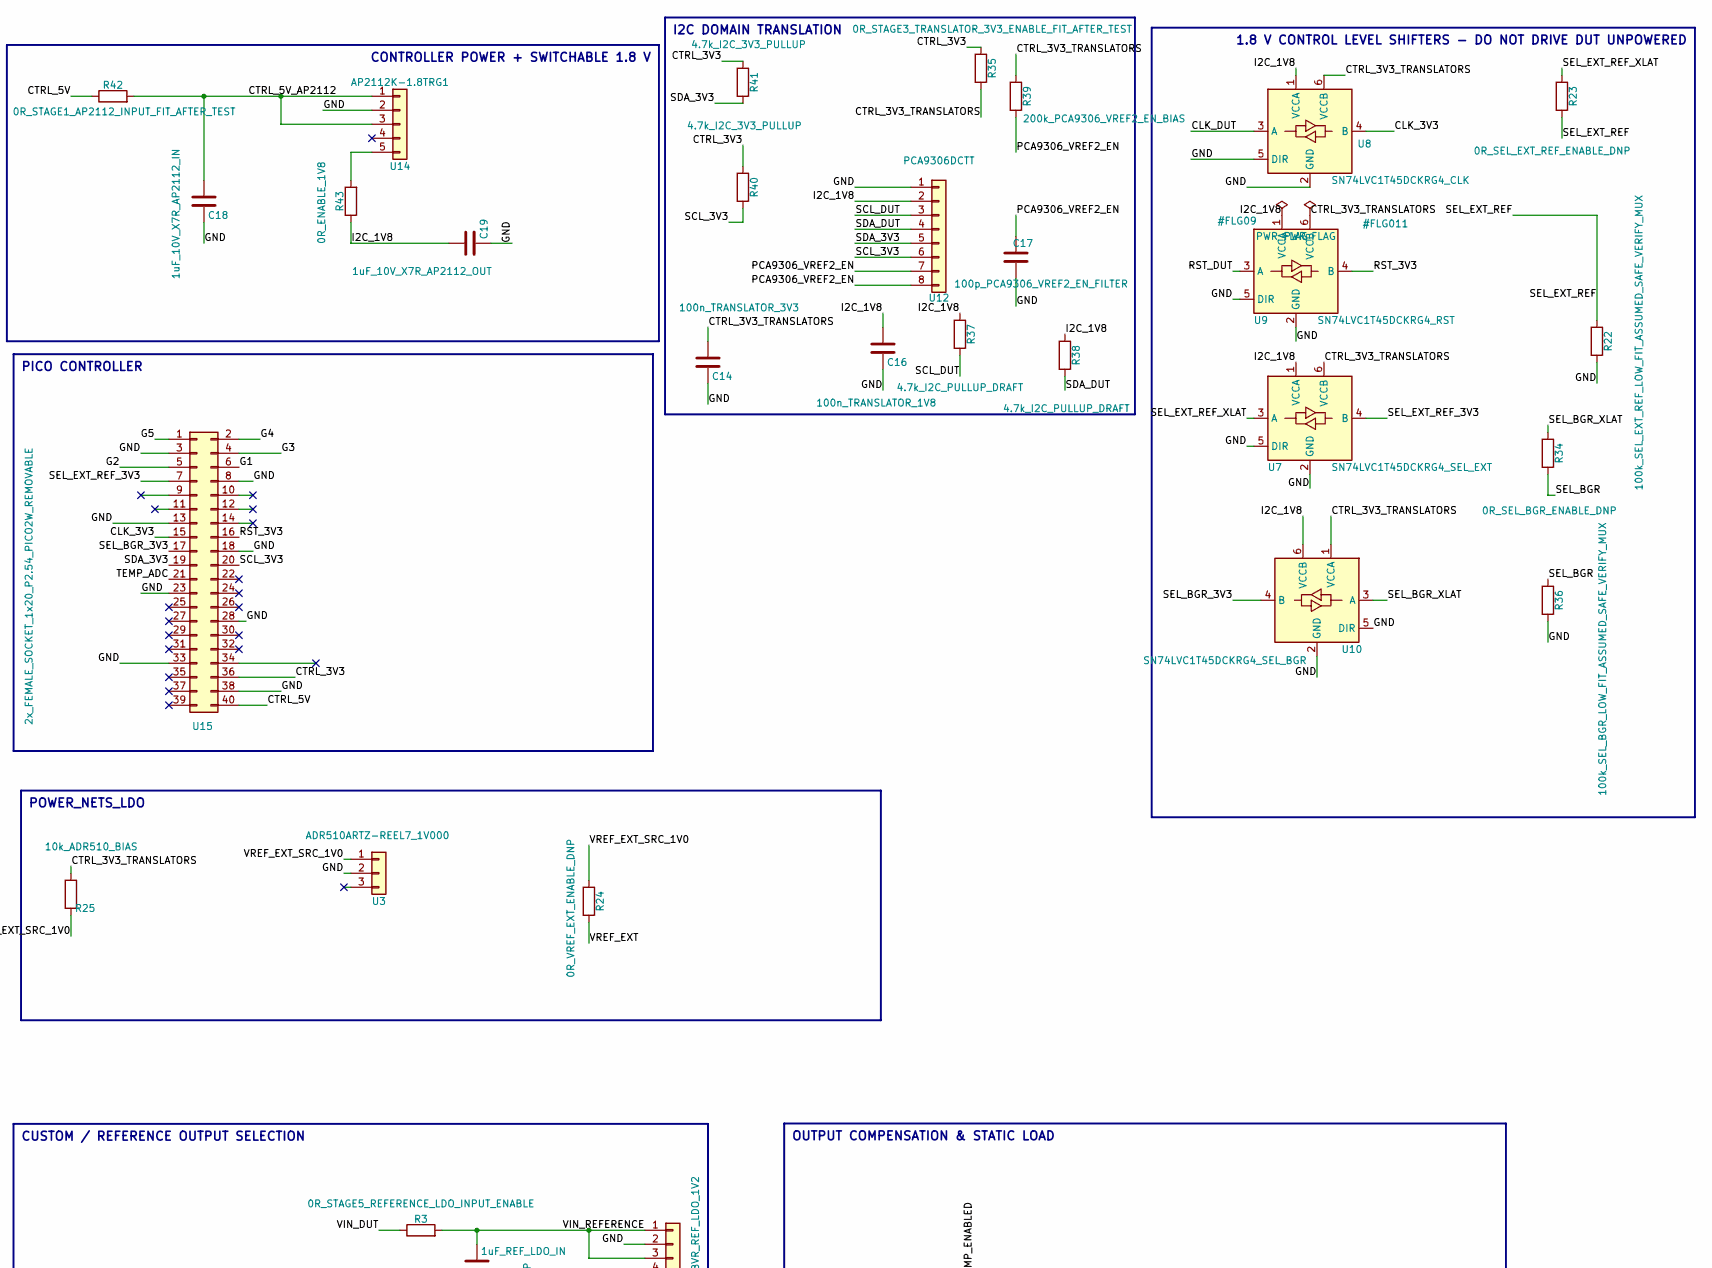
[picture p13: schematic ldo_eval.kicad_sch, part in row 1, column 2]

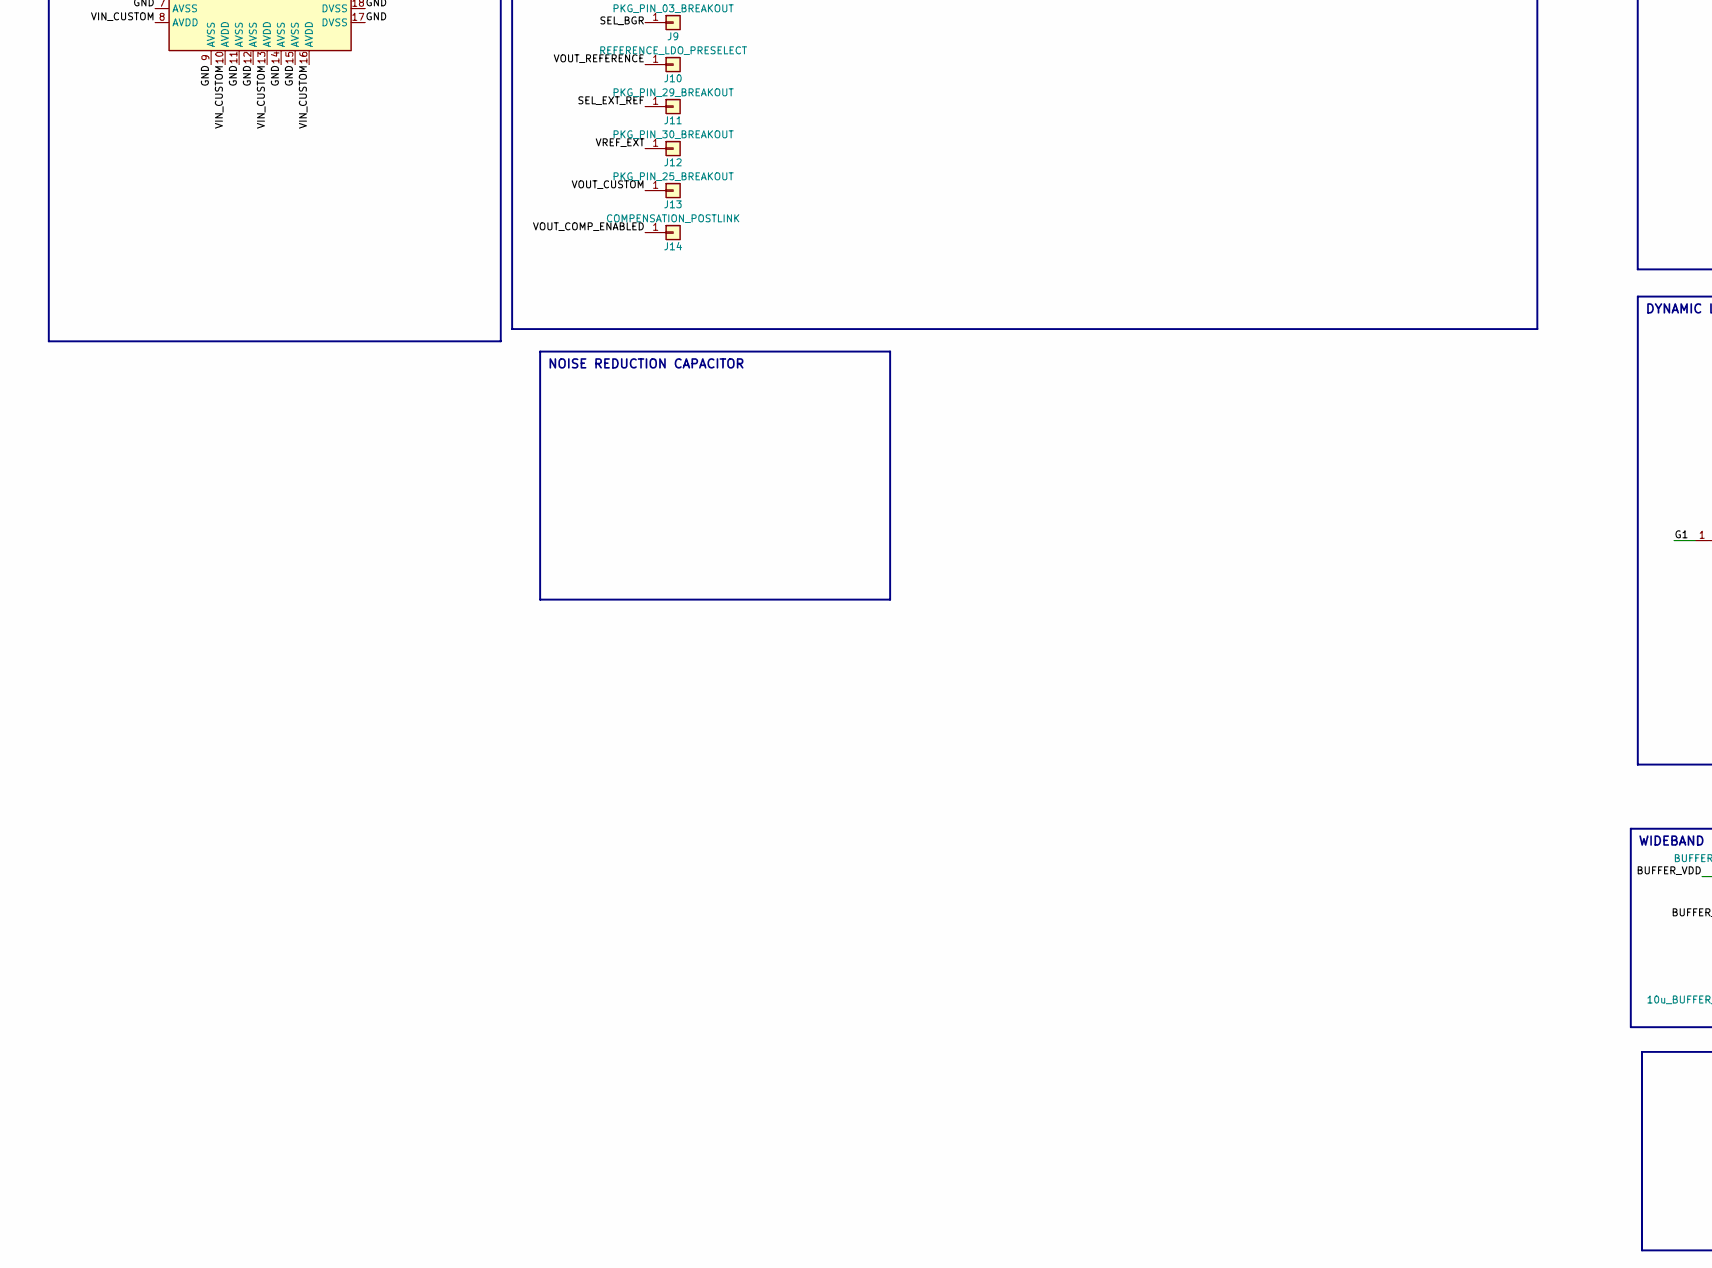
[picture p14: schematic ldo_eval.kicad_sch, part in row 2, column 1]

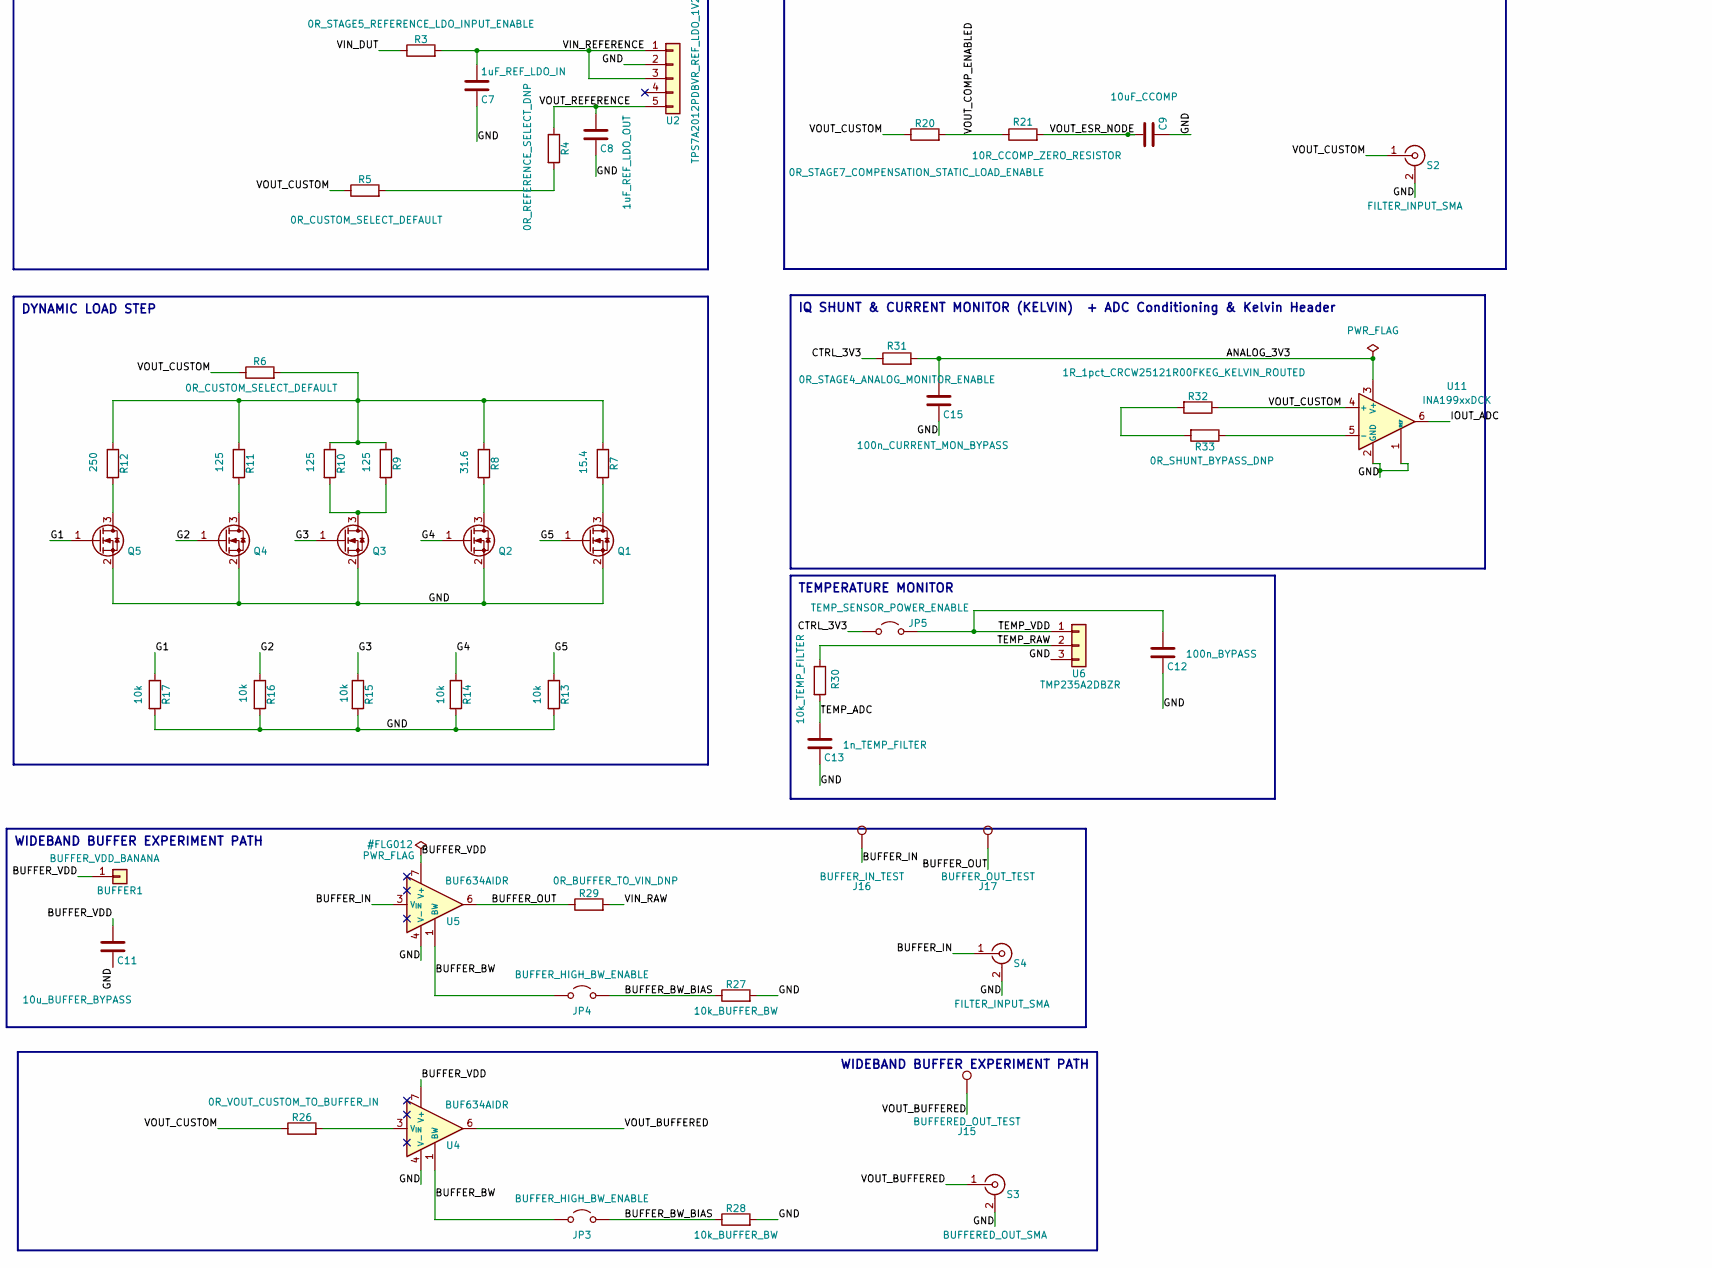
[picture p15: schematic ldo_eval.kicad_sch, part in row 2, column 2]

Parts:
BUFFER1: BUFFER_VDD_BANANA; CalTest_CT3151
C1, C4: 0.1nF; C_0805_2012Metric; Manufacturer Part Number C0805C101K8RACTU
C2: 100nF_INPUT_DECOUPLING; C_0805_2012Metric
C3: 10uF_INPUT_BYPASS; C_0805_2012Metric
C5: 100nF; C_0805_2012Metric; Manufacturer Part Number C0805C104K8RACTU
C6: 10uF; C_0805_2012Metric; Manufacturer Part Number C0805C106K8RACTU
C7: 1uF_REF_LDO_IN; C_0603_1608Metric
C8: 1uF_REF_LDO_OUT; C_0603_1608Metric
C9: 10uF_CCOMP; C_0805_2012Metric
C10: 100nF_BGR_VREF_NOISE_REDUCTION; C_0603_1608Metric
C11: 10u_BUFFER_BYPASS; C_0805_2012Metric
C12: 100n_BYPASS; C_0805_2012Metric
C13: 1n_TEMP_FILTER; C_0805_2012Metric
C14: 100n_TRANSLATOR_3V3; C_0603_1608Metric
C15: 100n_CURRENT_MON_BYPASS; C_0603_1608Metric
C16: 100n_TRANSLATOR_1V8; C_0603_1608Metric
C17: 100p_PCA9306_VREF2_EN_FILTER; C_0603_1608Metric
C18: 1uF_10V_X7R_AP2112_IN; C_0805_2012Metric
C19: 1uF_10V_X7R_AP2112_OUT; C_0805_2012Metric
DVIN1: DVIN_RAW; CalTest_CT3151
GND1: GND_BANANA_BLACK; CalTest_CT3151
J1, J3: PKG_PIN_01_BREAKOUT; PinHeader_1x01_P2.54mm_Vertical
J2: PKG_PIN_05_BREAKOUT; PinHeader_1x01_P2.54mm_Vertical
J4: PKG_PIN_19_BREAKOUT; PinHeader_1x01_P2.54mm_Vertical
J5: PKG_PIN_21_BREAKOUT; PinHeader_1x01_P2.54mm_Vertical
J6: PKG_PIN_20_BREAKOUT; PinHeader_1x01_P2.54mm_Vertical
J7: PKG_PIN_22_BREAKOUT; PinHeader_1x01_P2.54mm_Vertical
J8: PKG_PIN_24_BREAKOUT; PinHeader_1x01_P2.54mm_Vertical
J9: PKG_PIN_03_BREAKOUT; PinHeader_1x01_P2.54mm_Vertical
J10: REFERENCE_LDO_PRESELECT; PinHeader_1x01_P2.54mm_Vertical
J11: PKG_PIN_29_BREAKOUT; PinHeader_1x01_P2.54mm_Vertical
J12: PKG_PIN_30_BREAKOUT; PinHeader_1x01_P2.54mm_Vertical
J13: PKG_PIN_25_BREAKOUT; PinHeader_1x01_P2.54mm_Vertical
J14: COMPENSATION_POSTLINK; PinHeader_1x01_P2.54mm_Vertical
J15: BUFFERED_OUT_TEST; PinHeader_1x01_P2.54mm_Vertical
J16: BUFFER_IN_TEST; PinHeader_1x01_P2.54mm_Vertical
J17: BUFFER_OUT_TEST; PinHeader_1x01_P2.54mm_Vertical
J18: ADC_AND_ANALOG_MONITOR_HEADER; PinHeader_1x06_P2.54mm_Vertical
J19: AD2_3V3_SIDE_DEBUG_DRIVE; PinHeader_1x08_P2.54mm_Vertical
JP1, JP2: VIN_CURRENT_BREAK; PinHeader_1x02_P2.54mm_Vertical
JP3, JP4: BUFFER_HIGH_BW_ENABLE; PinHeader_1x02_P2.54mm_Vertical
JP5: TEMP_SENSOR_POWER_ENABLE; PinHeader_1x02_P2.54mm_Vertical
Q1, Q2, Q3, Q4, Q5: FDV305N:SOT95P240X111; SOT-23
R1, R18: 0R_STAGE6_CUSTOM_LDO_INPUT_ENABLE; R_0805_2012Metric
R2, R19: 0R_VIN_SHUNT_DRAFT; R_2512_6332Metric
R3: 0R_STAGE5_REFERENCE_LDO_INPUT_ENABLE; R_0805_2012Metric
R4: 0R_REFERENCE_SELECT_DNP; R_0805_2012Metric
R5, R6: 0R_CUSTOM_SELECT_DEFAULT; R_0805_2012Metric
R7: 15.4; R_0805_2012Metric_Pad1.20x1.40mm_HandSolder
R8: 31.6; R_0805_2012Metric_Pad1.20x1.40mm_HandSolder
R9, R10, R11: 125; R_0805_2012Metric_Pad1.20x1.40mm_HandSolder
R12: 250; R_0805_2012Metric_Pad1.20x1.40mm_HandSolder
R13, R14, R15, R16, R17: 10k; R_0603_1608Metric
R20: 0R_STAGE7_COMPENSATION_STATIC_LOAD_ENABLE; R_0805_2012Metric
R21: 10R_CCOMP_ZERO_RESISTOR; R_0805_2012Metric
R22: 100k_SEL_EXT_REF_LOW_FIT_ASSUMED_SAFE_VERIFY_MUX; R_0603_1608Metric
R23: 0R_SEL_EXT_REF_ENABLE_DNP; R_0603_1608Metric
R24: 0R_VREF_EXT_ENABLE_DNP; R_0603_1608Metric
R25: 10k_ADR510_BIAS; R_0603_1608Metric
R26: 0R_VOUT_CUSTOM_TO_BUFFER_IN; R_0805_2012Metric
R27, R28: 10k_BUFFER_BW; R_0805_2012Metric
R29: 0R_BUFFER_TO_VIN_DNP; R_0805_2012Metric
R30: 10k_TEMP_FILTER; R_0805_2012Metric
R31: 0R_STAGE4_ANALOG_MONITOR_ENABLE; R_0805_2012Metric
R32: 1R_1pct_CRCW25121R00FKEG_KELVIN_ROUTED; R_2512_6332Metric
R33: 0R_SHUNT_BYPASS_DNP; R_0805_2012Metric
R34: 0R_SEL_BGR_ENABLE_DNP; R_0603_1608Metric
R35: 0R_STAGE3_TRANSLATOR_3V3_ENABLE_FIT_AFTER_TEST; R_0805_2012Metric
R36: 100k_SEL_BGR_LOW_FIT_ASSUMED_SAFE_VERIFY_MUX; R_0603_1608Metric
R37, R38: 4.7k_I2C_PULLUP_DRAFT; R_0603_1608Metric
R39: 200k_PCA9306_VREF2_EN_BIAS; R_0603_1608Metric
R40, R41: 4.7k_I2C_3V3_PULLUP; R_0603_1608Metric
R42: 0R_STAGE1_AP2112_INPUT_FIT_AFTER_TEST; R_0805_2012Metric
R43: 0R_ENABLE_1V8; R_0805_2012Metric
S1: VIN_TRANSIENT_IN; SMA_Amphenol_132134_Vertical
S2, S4: FILTER_INPUT_SMA; SMA_Amphenol_132134_Vertical
S3: BUFFERED_OUT_SMA; SMA_Amphenol_132134_Vertical
U1: CUSTOM_LDO_GRP6_TEMP; QFN32_7x7_P0.65_TEMP
U2: TPS7A2012PDBVR_REF_LDO_1V2; SOT-23-5
U3: ADR510ARTZ-REEL7_1V000; SOT-23
U4, U5: BUF634AIDR; SOIC-8_3.9x4.9mm_P1.27mm
U6: TMP235A2DBZR; SOT-23
U7: SN74LVC1T45DCKRG4_SEL_EXT; SOT-363_SC-70-6
U8: SN74LVC1T45DCKRG4_CLK; SOT-363_SC-70-6
U9: SN74LVC1T45DCKRG4_RST; SOT-363_SC-70-6
U10: SN74LVC1T45DCKRG4_SEL_BGR; SOT-363_SC-70-6
U11: INA199xxDCK; SOT-363_SC-70-6
U12: PCA9306DCTT; SSOP-8_2.95x2.8mm_P0.65mm
U14: AP2112K-1.8TRG1; SOT-23-5
U15: 2x_FEMALE_SOCKET_1x20_P2.54_PICO2W_REMOVABLE; Pico_2W_Dual_1x20_Female_Sockets
VIN1: VIN_BANANA_RED; CalTest_CT3151

Connections:
/ANALOG_3V3: C15.1, J18.1, R31.2, U11.3 (V+)
/BUFFER_BW: JP3.1 (A), JP4.1 (A), U4.1 (BW), U5.1 (BW)
/BUFFER_BW_BIAS: JP3.2 (B), JP4.2 (B), R27.1, R28.1
/BUFFER_IN: J16.1 (1_1), S4.1 (In), U5.3 (V_{IN})
/BUFFER_OUT: J17.1 (1_1), R29.1, U5.6
/BUFFER_VDD: BUFFER1.1 (Pin_1_1), C11.1, U4.7 (V+), U5.7 (V+)
/CLK_3V3: J19.5, U8.4 (B), U15.15
/CLK_DUT: J4.1 (Pin_1_1), U1.19 (CLK), U8.3 (A)
/CTRL_3V3: J19.6, JP5.1 (A), R31.1, R35.1, R40.1, R41.1, U15.36
/CTRL_3V3_TRANSLATORS: C14.1, R25.1, R35.2, R39.1, U7.6 (VCCB), U8.6 (VCCB), U9.6 (VCCB), U10.1 (VCCA)
/CTRL_5V: R42.1, U15.40
/CTRL_5V_AP2112: C18.1, R42.2, U14.1, U14.3
/DVIN_CUSTOM: C4.1, C5.1, C6.1, J8.1 (Pin_1_1), R18.2, U1.24 (DVDD)
/DVIN_DUT: R18.1, R19.2
/DVIN_RAW: DVIN1.1 (Pin_1_1), JP2.1 (A)
/G1: Q5.1 (G), R17.1, U15.6
/G2: Q4.1 (G), R16.1, U15.5
/G3: Q3.1 (G), R15.1, U15.4
/G4: Q2.1 (G), R14.1, U15.2
/G5: Q1.1 (G), R13.1, U15.1
/GND: C1.2, C2.2, C3.2, C4.2, C5.2, C6.2, C7.2, C8.2, C9.2, C10.2, C11.2, C12.2, C13.2, C14.2, C15.2, C16.2, C17.2, C18.2, C19.2, GND1.1 (Pin_1_1), J1.1 (Pin_1_1), J18.4, J19.8, Q1.2 (S), Q2.2 (S), Q3.2 (S), Q4.2 (S), Q5.2 (S), R13.2, R14.2, R15.2, R16.2, R17.2, R22.2, R27.2, R28.2, R36.2, S1.2 (Ext), S2.2 (Ext), S3.2 (Ext), S4.2 (Ext), U1.1 (AVSS), U1.2 (AVSS), U1.4 (AVSS), U1.6 (AVSS), U1.7 (AVSS), U1.9 (AVSS), U1.11 (AVSS), U1.12 (AVSS), U1.14 (AVSS), U1.15 (AVSS), U1.17 (DVSS), U1.18 (DVSS), U1.23 (DVSS), U1.31 (AVSS), U2.2, U3.2, U4.4 (V-), U5.4 (V-), U6.3, U7.2 (GND), U7.5 (DIR), U8.2 (GND), U8.5 (DIR), U9.2 (GND), U9.5 (DIR), U10.2 (GND), U10.5 (DIR), U11.1 (REF), U11.2 (GND), U12.1, U14.2, U15.3, U15.8, U15.13, U15.18, U15.23, U15.28, U15.33, U15.38
/I2C_1V8: C16.1, C19.1, J18.2, R37.1, R38.1, R43.1, U7.1 (VCCA), U8.1 (VCCA), U9.1 (VCCA), U10.6 (VCCB), U12.2
/IOUT_ADC: J18.3, U11.6
/IREF_MON: J18.6, U1.28 (IREF)
/PCA9306_VREF2_EN: C17.1, R39.2, U12.7, U12.8
/RST_3V3: J19.4, U9.4 (B), U15.16
/RST_DUT: J6.1 (Pin_1_1), U1.20 (RST), U9.3 (A)
/SCL_3V3: J19.1, R40.2, U12.6, U15.20
/SCL_DUT: J5.1 (Pin_1_1), R37.2, U1.21 (SCL_IN), U12.3
/SDA_3V3: J19.2, R41.2, U12.5, U15.19
/SDA_DUT: J7.1 (Pin_1_1), R38.2, U1.22 (SDA_IN), U12.4
/SEL_BGR: J9.1 (Pin_1_1), R34.2, R36.1, U1.3 (SEL_BGR)
/SEL_BGR_3V3: J19.3, U10.4 (B), U15.17
/SEL_BGR_XLAT: R34.1, U10.3 (A)
/SEL_EXT_REF: J11.1 (Pin_1_1), R22.1, R23.2, U1.29 (SEL_EXT_REF)
/SEL_EXT_REF_3V3: J19.7, U7.4 (B), U15.7
/SEL_EXT_REF_XLAT: R23.1, U7.3 (A)
/TEMP_ADC: C13.1, R30.2, U15.21
/TEMP_RAW: R30.1, U6.2
/TEMP_VDD: C12.1, JP5.2 (B), U6.1
/VIN_CUSTOM: C1.1, C2.1, C3.1, J2.1 (Pin_1_1), R1.2, U1.5 (AVDD), U1.8 (AVDD), U1.10 (AVDD), U1.13 (AVDD), U1.16 (AVDD), U1.26 (AVDD), U1.32 (AVDD)
/VIN_DUT: J3.1 (Pin_1_1), R1.1, R2.2, R3.1
/VIN_RAW: JP1.1 (A), R29.2, S1.1 (In), VIN1.1 (Pin_1_1)
/VIN_REFERENCE: C7.1, R3.2, U2.1, U2.3
/VIN_SENSE: JP1.2 (B), R2.1
/VOUT_BUFFERED: J15.1 (1_1), S3.1 (In), U4.6
/VOUT_COMP_ENABLED: J14.1 (Pin_1_1), R20.2, R21.1
/VOUT_CUSTOM: J13.1 (Pin_1_1), R5.1, R6.1, R20.1, R26.1, R32.1, S2.1 (In), U1.25 (VOUT), U11.4 (+)
/VOUT_ESR_NODE: C9.1, R21.2
/VOUT_REFERENCE: C8.1, J10.1 (Pin_1_1), R4.1, U2.5
/VREF_EXT: J12.1 (Pin_1_1), R24.2, U1.30 (VREF_EXT)
/VREF_EXT_SRC_1V0: R24.1, R25.2, U3.1
/VREF_MON: C10.1, J18.5, U1.27 (VREF)
unnamed: JP2.2 (B), R19.1
unnamed: Q1.3 (D), R7.2
unnamed: Q2.3 (D), R8.2
unnamed: Q3.3 (D), R9.2, R10.2
unnamed: Q4.3 (D), R11.2
unnamed: Q5.3 (D), R12.2
unnamed: R4.2, R5.2
unnamed: R6.2, R7.1, R8.1, R9.1, R10.1, R11.1, R12.1
unnamed: R32.2, R33.2
unnamed: R26.2, U4.3 (V_{IN})
unnamed: R33.1, U11.5 (-)
unnamed: R43.2, U14.5

Notes on the sheet:
PICO CONTROLLER
WIDEBAND BUFFER EXPERIMENT PATH
DYNAMIC LOAD STEP
CUSTOM LDO (QFN-32 + EP)
CUSTOM / REFERENCE OUTPUT SELECTION
POWER_NETS_LDO
NOISE REDUCTION CAPACITOR
POWER-RAIL TEST ACCESS
CONTROLLER POWER + SWITCHABLE 1.8 V
TEMPERATURE MONITOR
I2C DOMAIN TRANSLATION
1.8 V CONTROL LEVEL SHIFTERS - DO NOT DRIVE DUT UNPOWERED
BENCH INPUT, PROTECTION & STAGED DUT POWER
OUTPUT COMPENSATION & STATIC LOAD
IQ SHUNT & CURRENT MONITOR (KELVIN) + ADC Conditioning & Kelvin Header
PACKAGE-PIN BREAKOUT / PROBING
EXTERNAL POWER / DEBUG CONNECTORS

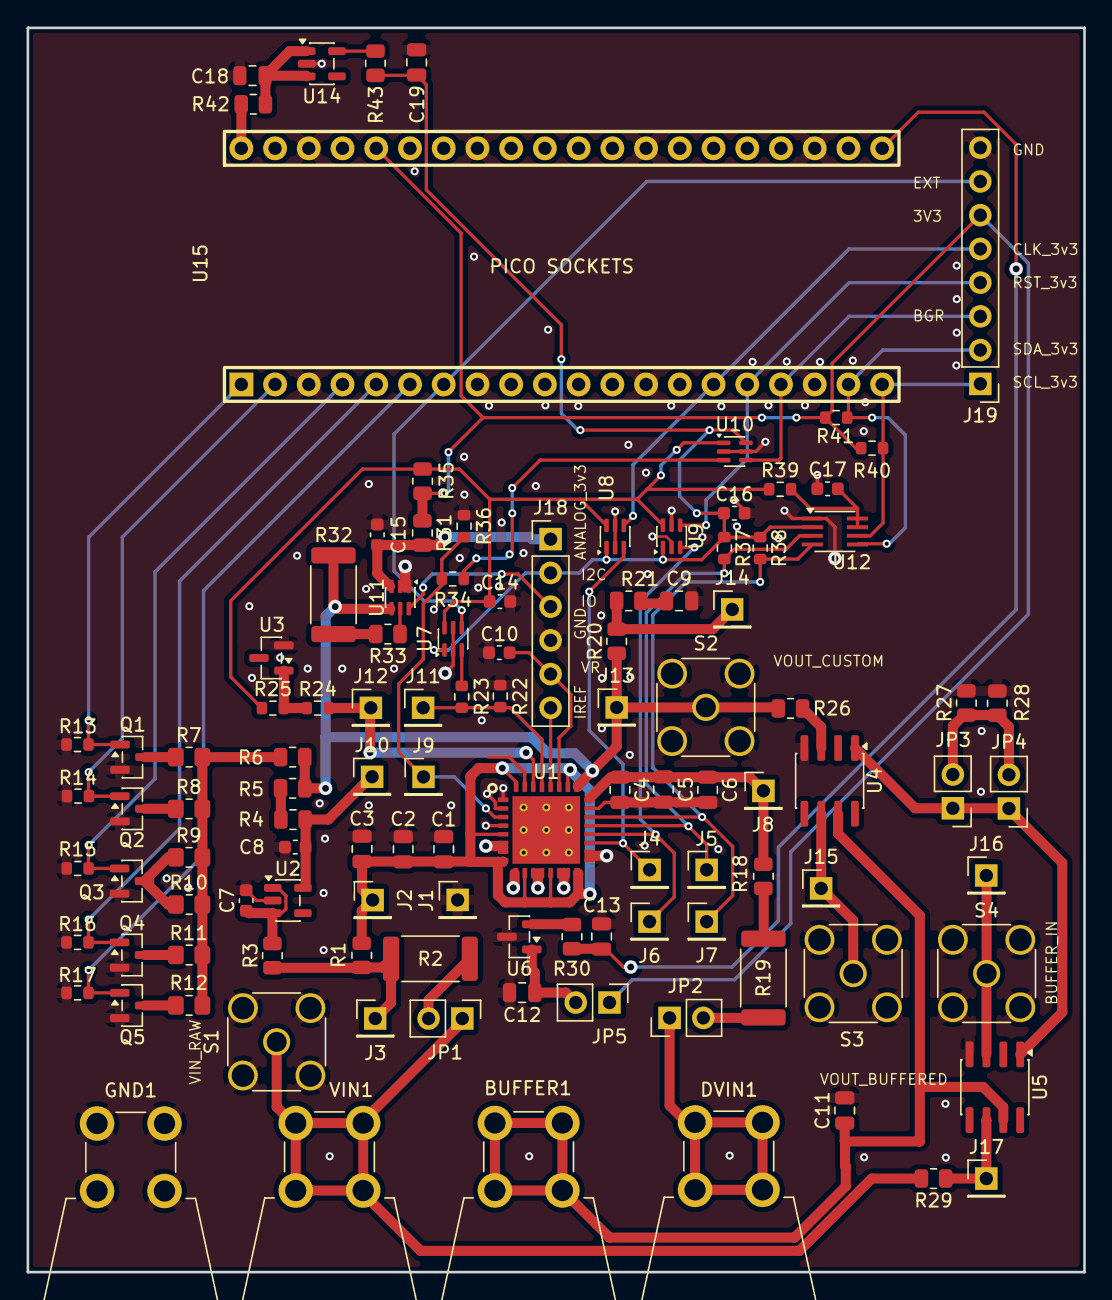
[picture p16: board ldo_eval.kicad_pcb from above]

Board: 4 copper layers, 79.6 x 93.7 mm, 113 parts (0 on the bottom side), 65 nets.
